dyeghikoo/design-power-distributor/README.md

# design-power-distributor
Diseño de un distribuidor de potencia con ADS
