dyeghikoo/design-power-distributor/MEMORIA STEP1.pdf

## Juan Diego Sierra Fernández & Daniel Sanz Muñoz

# PRÁCTICAS MEDIOS DE TRANSMISIÓN

# PRACTICA 1

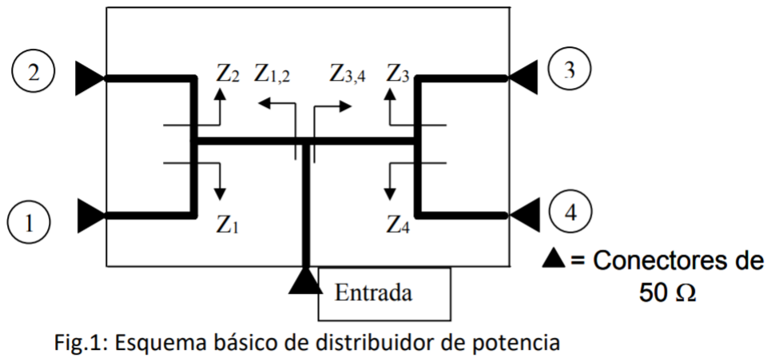
[picture p1: figure]
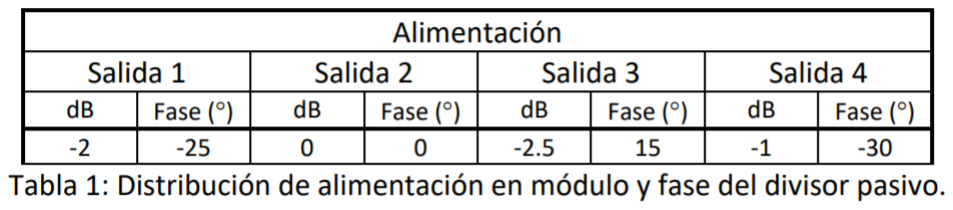
[picture p2: figure]

Practica 1 Medios de Transmisión

## DISEÑO 1: DISTRIBUIDOR DE POTENCIA

Nuestro objetivo es diseñar un circuito como el mostrado en la figura 1 cumpliendo los requisitos que aparecen en la tabla 1 además de cumplir las especificaciones que se muestran a continuación:

- La impedancia característica de las líneas que se implementen esté en el rango
25 < Z0i < 85 (Ω).
- Adaptadores en λ/4.
- Banda de trabajo: 3.2 – 3.8 GHz.
- Coeficiente de reflexión a la entrada del circuito: < - 30 dB
- Rizado en amplitud de transmisión: +/- 0.5 dB
- Rizado en fase de transmisión con respecto al puerto de salida tomado como referencia: +/-5 º con respecto al valor nominal indicado en la tabla de especificaciones.

Para ello comenzamos diseñando los adaptadores en las salidas, esto lo conseguimos usando la tabla anterior que nos da la relación de potencias entre las distintas ramas del circuito, en este caso todas referenciadas a Z2.

Para todas las ramas del circuito vamos a utilizar adaptadores en λ/4, con esto podemos

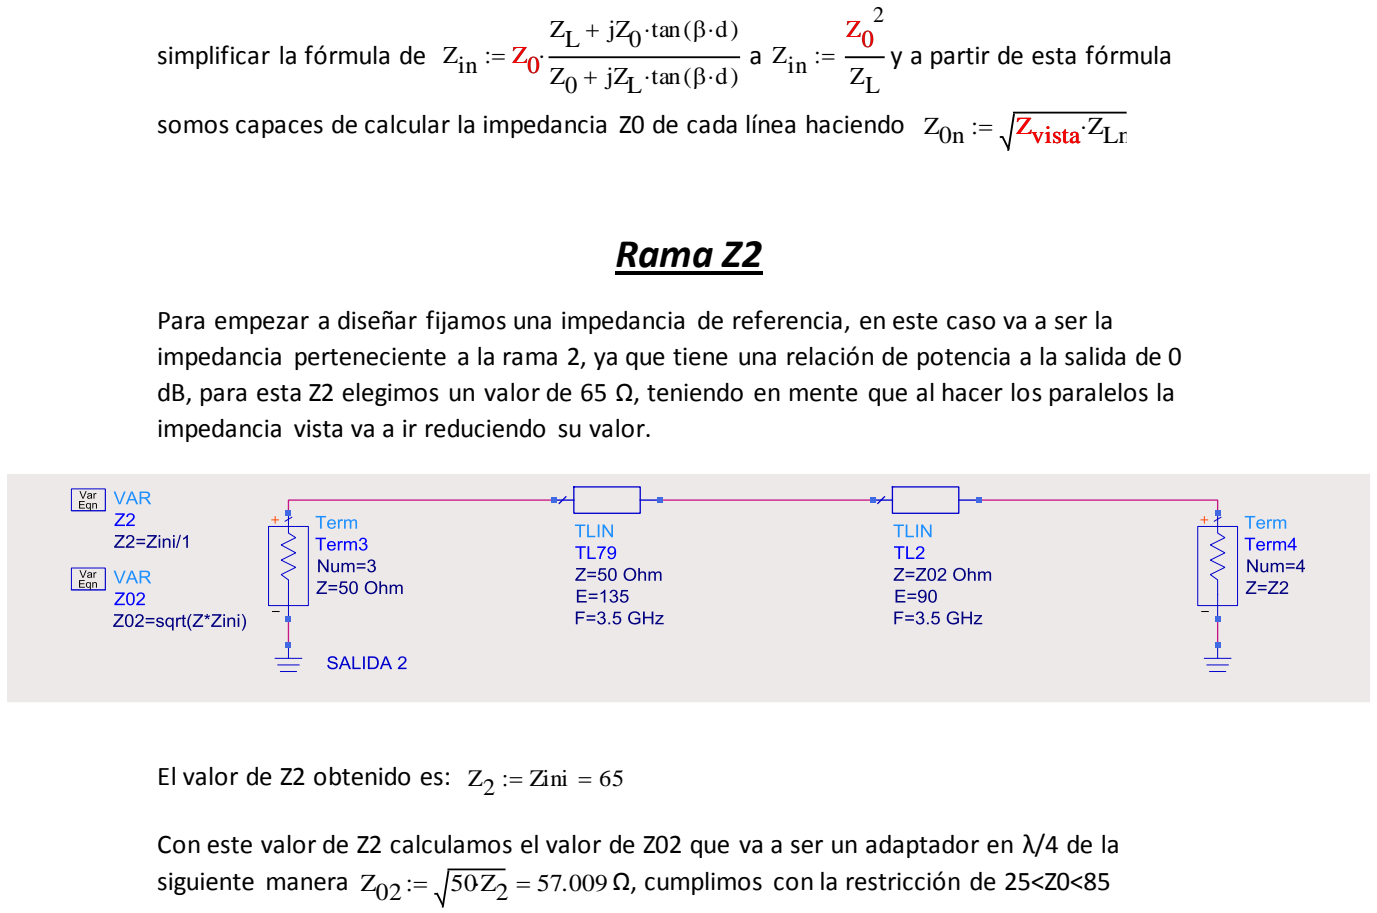
[picture p3: figure]
Rama Z2; El valor de Z2 obtenido es:; Zin; ·tan(β·d); jZL; Zvista ZLn := Z; · vista Z2; := Zini = 65 Z02

simplificar la fórmula de | a | y a partir de esta fórmula

somos capaces de calcular la impedancia Z0 de cada línea haciendo

Para empezar a diseñar fijamos una impedancia de referencia, en este caso va a ser la impedancia perteneciente a la rama 2, ya que tiene una relación de potencia a la salida de 0 dB, para esta Z2 elegimos un valor de 65 Ω, teniendo en mente que al hacer los paralelos la impedancia vista va a ir reduciendo su valor.

Con este valor de Z2 calculamos el valor de Z02 que va a ser un adaptador en λ/4 de la
siguiente manera | Ω, cumplimos con la restricción de 25<Z0<85

Con estos valores comprobamos la respuesta en frecuencia y el valor de Z02

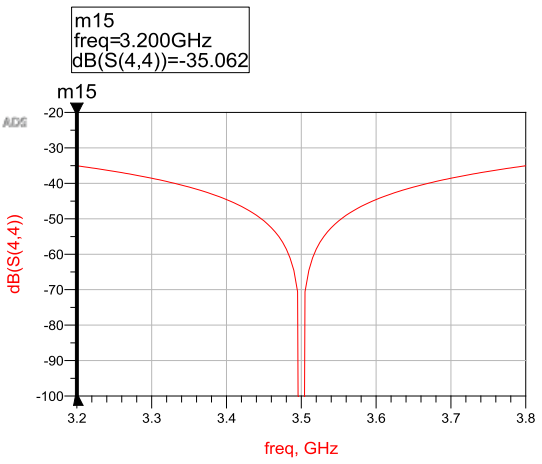
[picture p4: figure]
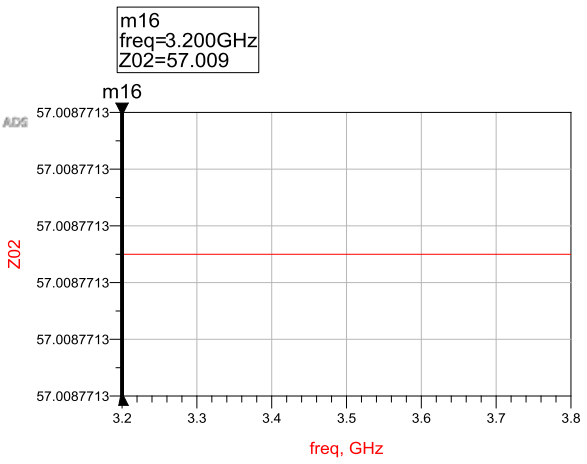
[picture p5: figure]

Observamos que a la frecuencia de diseño (3.5GHz) la adaptación es perfecta y en los extremos (3.2GHz y 3.8GHz) obtenemos una respuesta inferior a -30dB, cumpliendo con las restricciones del enunciado.

## Rama Z1

A partir de los datos de la tabla, la impedancia que hemos elegido y haciendo uso de la

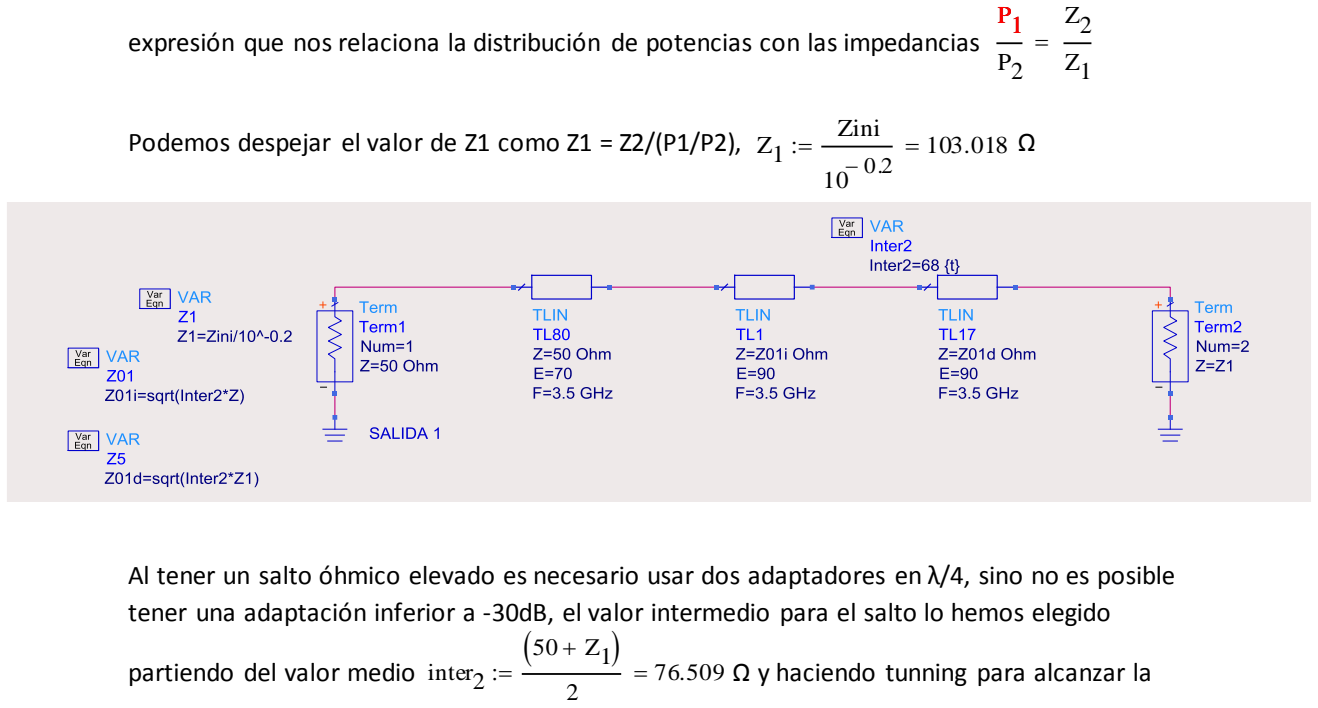
[picture p6: figure]
Zini; = 103.018 inter2

expresión que nos relaciona la distribución de potencias con las impedancias

Podemos despejar el valor de Z1 como Z1 = Z2/(P1/P2), | Ω

Al tener un salto óhmico elevado es necesario usar dos adaptadores en λ/4, sino no es posible tener una adaptación inferior a -30dB, el valor intermedio para el salto lo hemos elegido

partiendo del valor medio | Ω y haciendo tunning para alcanzar la

mejor respuesta posible, en este caso inter2=68.

Obtenemos la siguiente respuesta en frecuencia y valores de Z0:

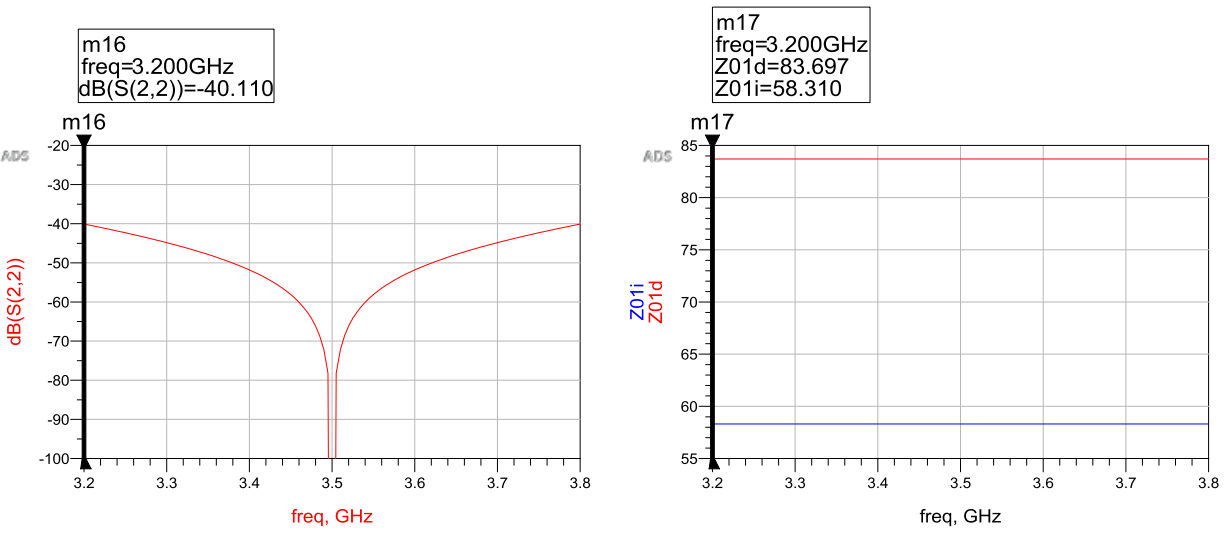
[picture p7: figure]

Observamos que a la frecuencia de diseño (3.5GHz) la adaptación es perfecta y en los extremos (3.2GHz y 3.8GHz) obtenemos una respuesta inferior a -30dB, en el caso de las impedancias ambas se encuentran dentro de los márgenes 25<Z0<85 Ω

## Rama Z3

A partir de los valores de la tabla y la siguiente relación P3/P2=Z2/Z3 somos capaces de

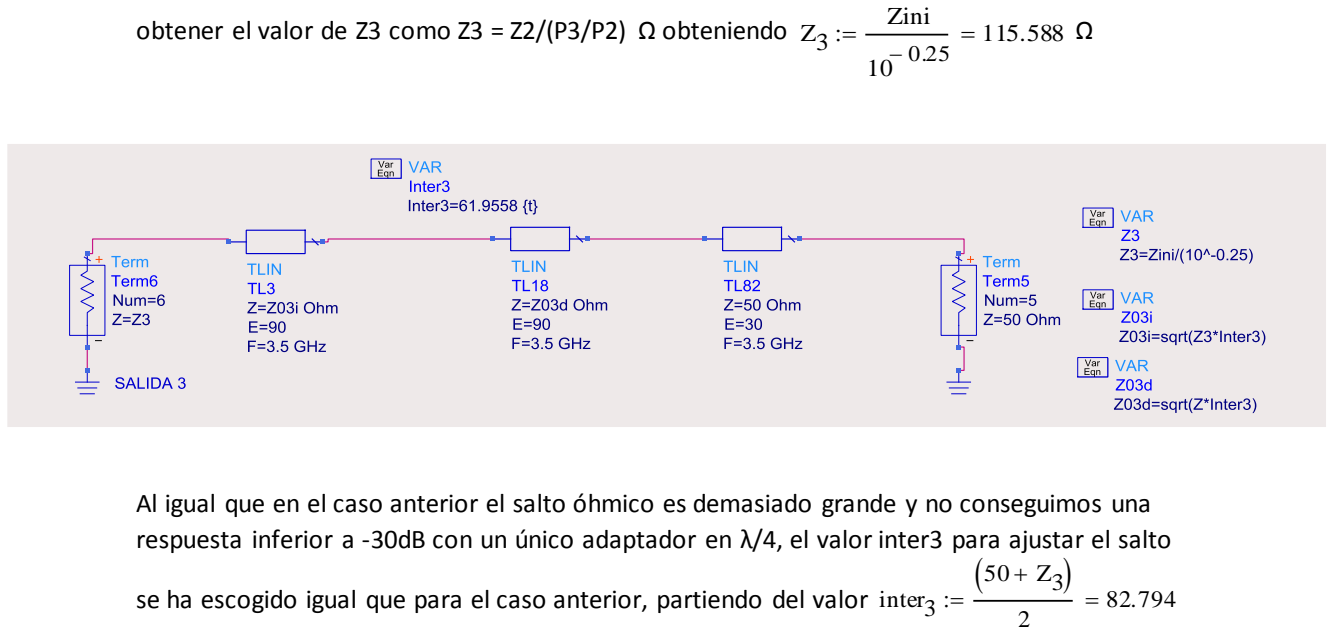
[picture p8: figure]
Zini; = 115.588 inter3

obtener el valor de Z3 como Z3 = Z2/(P3/P2) Ω obteniendo | Ω

Al igual que en el caso anterior el salto óhmico es demasiado grande y no conseguimos una respuesta inferior a -30dB con un único adaptador en λ/4, el valor inter3 para ajustar el salto

se ha escogido igual que para el caso anterior, partiendo del valor

Ω y ajustando el valor para obtener la mejor respuesta posible mediante tunning en este caso inter3 = 61.9558 Ω, para otros valores de inter3 obteníamos una respuesta inferior en dB pero dejábamos de cumplir la restricción para Z0 de 25<Z0<85 Ω.

Obtenemos la siguiente respuesta en frecuencia y valores de Z0:

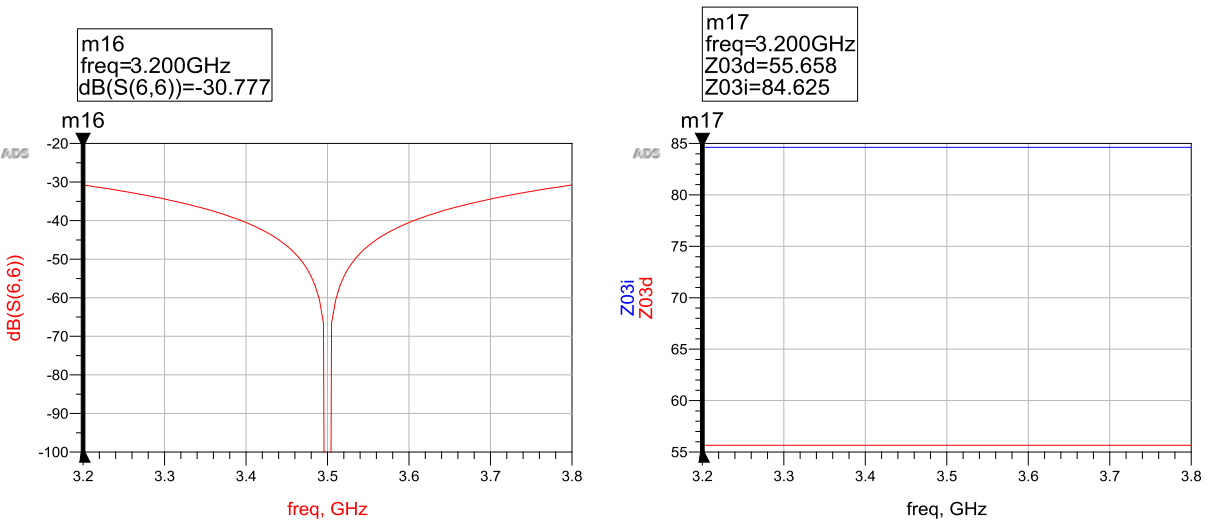
[picture p9: figure]

Observamos que a la frecuencia de diseño (3.5GHz) la adaptación es perfecta y en los extremos (3.2GHz y 3.8GHz) obtenemos una respuesta inferior a -30dB, en el caso de las impedancias ambas se encuentran dentro de los márgenes 25<Z0<85 Ω

## Rama Z4

A partir de los valores de la tabla y la siguiente relación P4/P2=Z2/Z4 somos capaces de

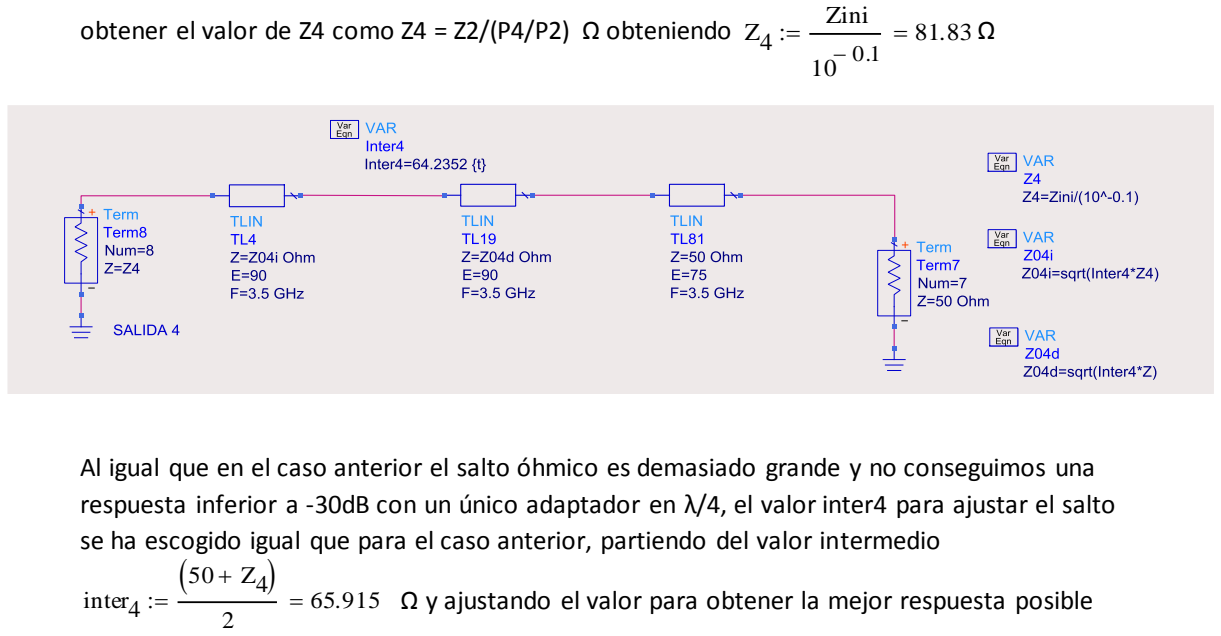
[picture p10: figure]
Zini; = 81.83 inter4

obtener el valor de Z4 como Z4 = Z2/(P4/P2) Ω obteniendo | Ω

Al igual que en el caso anterior el salto óhmico es demasiado grande y no conseguimos una respuesta inferior a -30dB con un único adaptador en λ/4, el valor inter4 para ajustar el salto se ha escogido igual que para el caso anterior, partiendo del valor intermedio

Ω y ajustando el valor para obtener la mejor respuesta posible

mediante tunning en este caso inter4 = 64.2352 Ω.

Obtenemos la siguiente respuesta en frecuencia y valores de Z0:

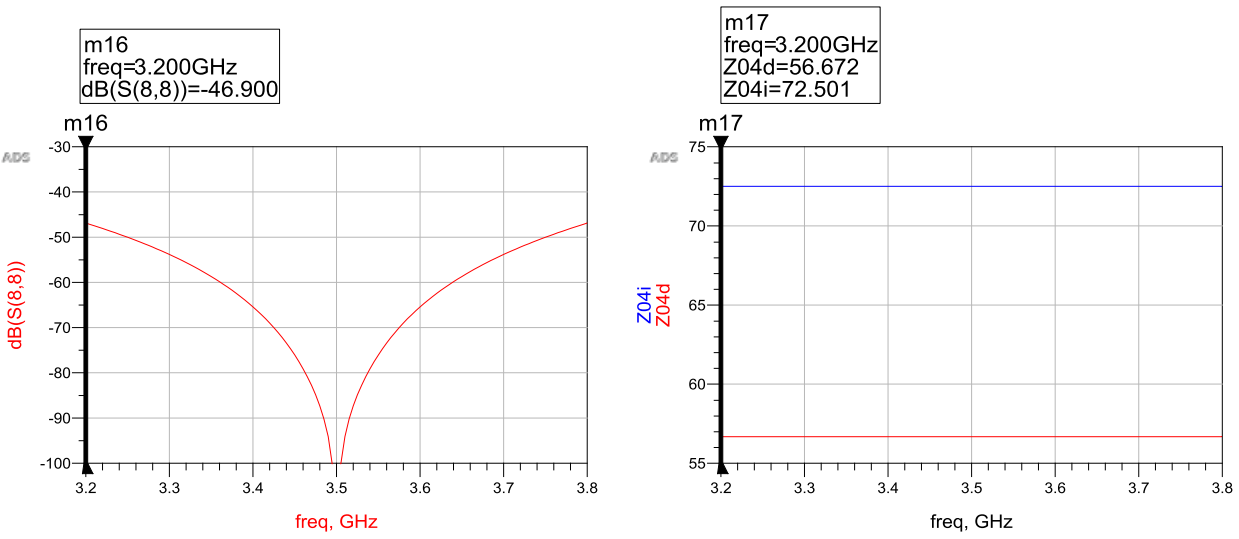
[picture p11: figure]

Observamos que a la frecuencia de diseño (3.5GHz) la adaptación es perfecta y en los extremos (3.2GHz y 3.8GHz) obtenemos una respuesta inferior a -30dB, en el caso de las impedancias ambas se encuentran dentro de los márgenes 25<Z0<85 Ω

Diseñando las ramas por separado hemos conseguido una adaptación inferior a -30dB en todas ellas, y unas impedancias Z0 dentro de los limites propuestos, ahora procedemos a unir las ramas y comprobar que seguimos manteniendo la adaptación.

## Rama Z1,2

En este caso la impedancia vista corresponde al paralelo Z12 = Z1||Z2,

Ω. Conectamos directamente las ramas a un generador de este

valor para ver si la respuesta sigue adaptada.

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
:= | = 39.854

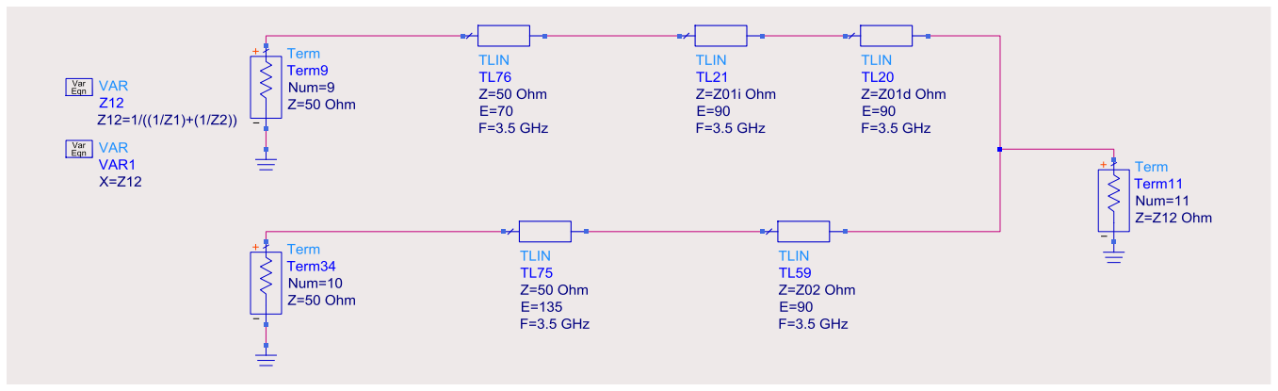
[picture p12: figure]
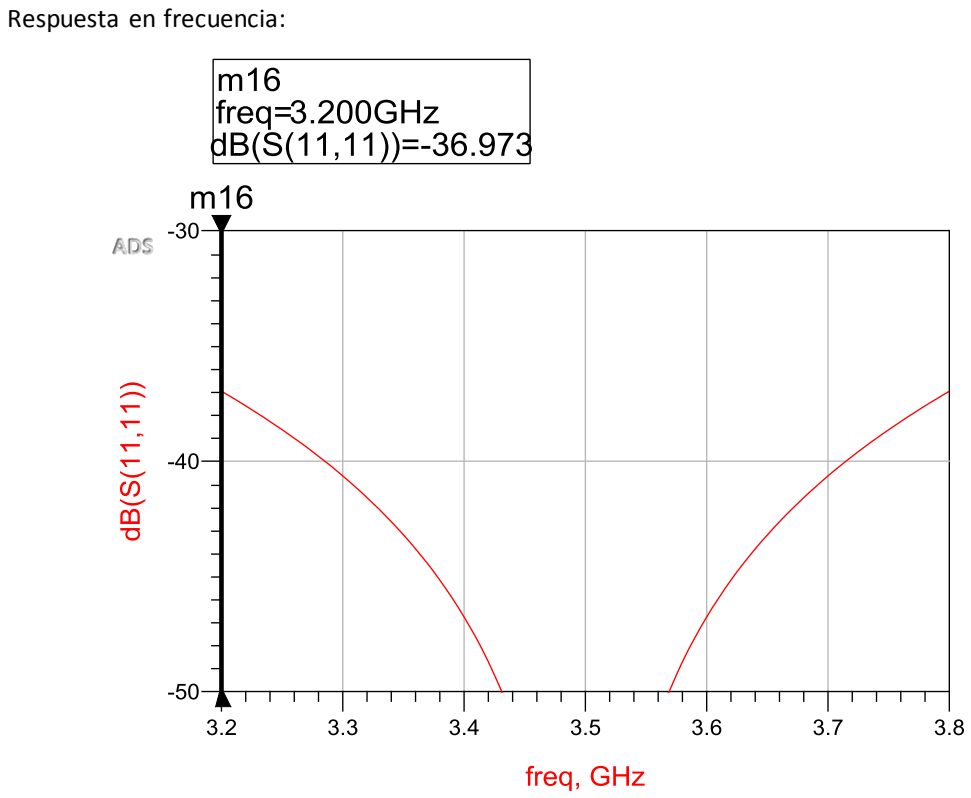
[picture p13: figure]
Respuesta en frecuencia:

La respuesta sigue adaptada y procedemos a colocar el adaptador λ/4:

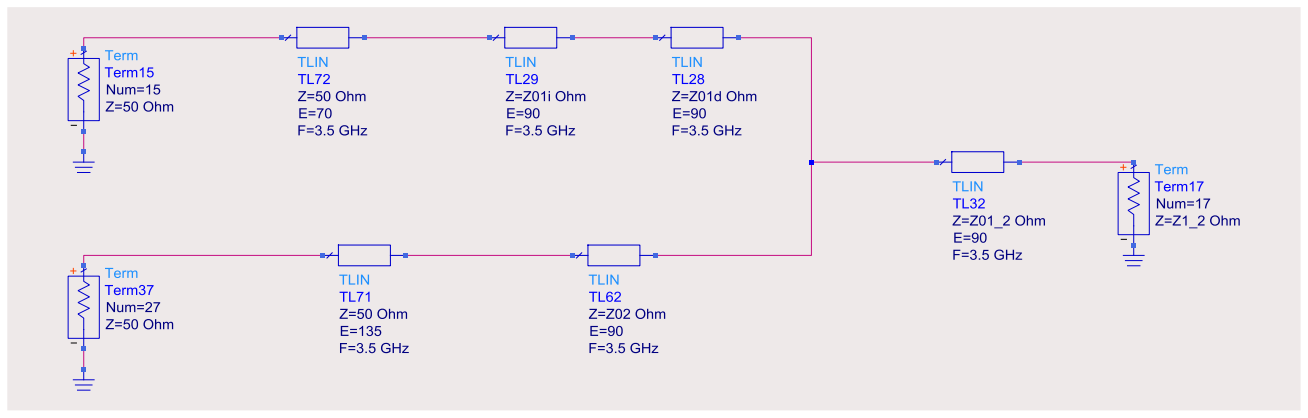
[picture p14: figure]

El valor Z = Z1_2 es un valor escogido por nosotros teniendo en mente que al hacer los paralelos en la última etapa la impedancia Z0 va a disminuir y es conveniente tener una impedancia por encima de 20 Ω, en este caso hemos escogido Z1_2 =60 Ω.

El valor de Z01_2 se calcula | Ω.

Respuesta en frecuencia e impedancia Z01_2:

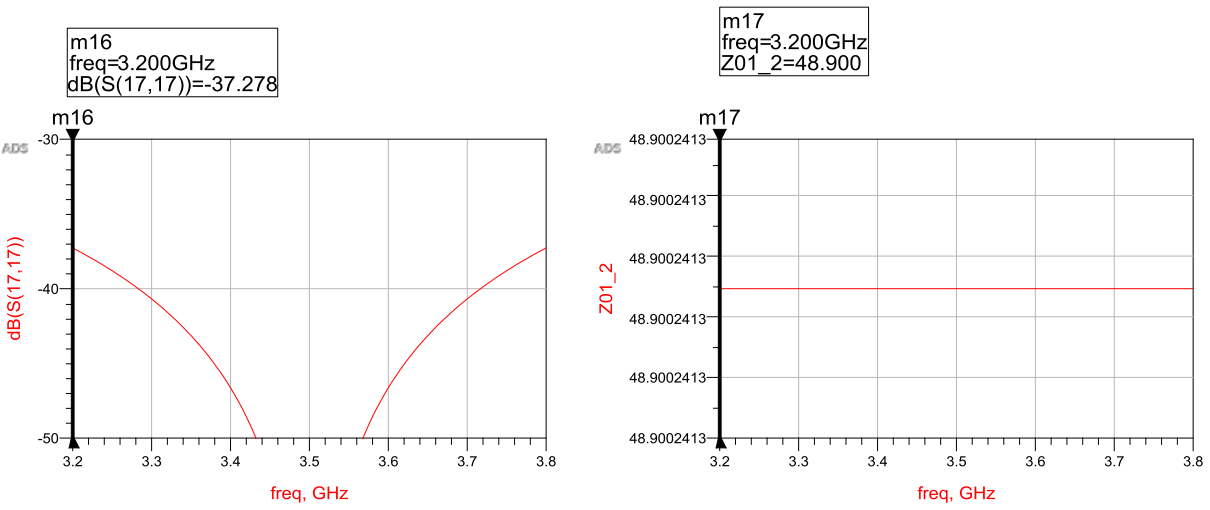
[picture p15: figure]
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

Z01_2 | Z12 Z1_2 := | · | = 48.9

## Rama Z3,4

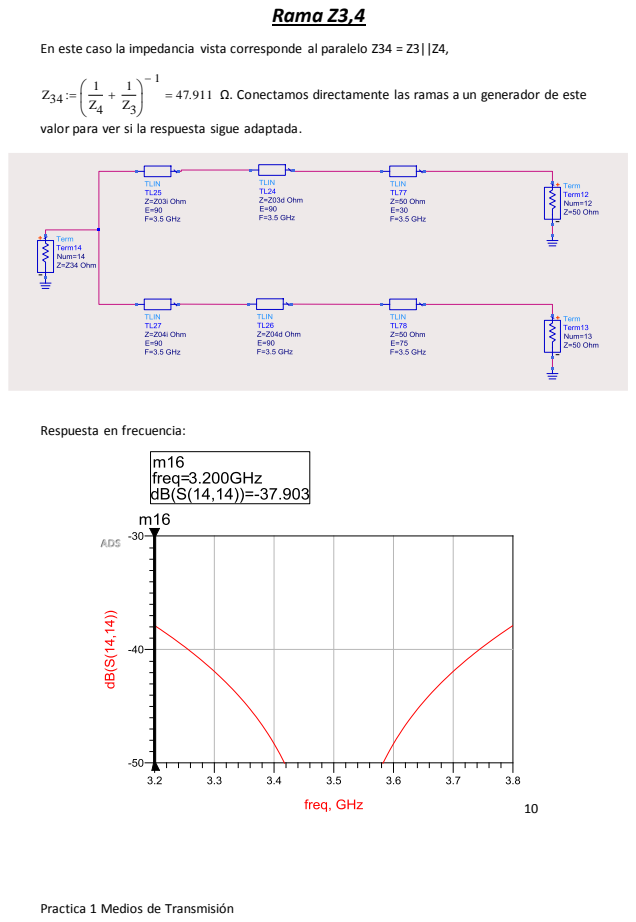
[picture p16: page 9]
valor para ver si la respuesta sigue adaptada.

En este caso la impedancia vista corresponde al paralelo Z34 = Z3||Z4,

Ω. Conectamos directamente las ramas a un generador de este

Respuesta en frecuencia:

La respuesta sigue adaptada y procedemos a colocar el adaptador λ/4:

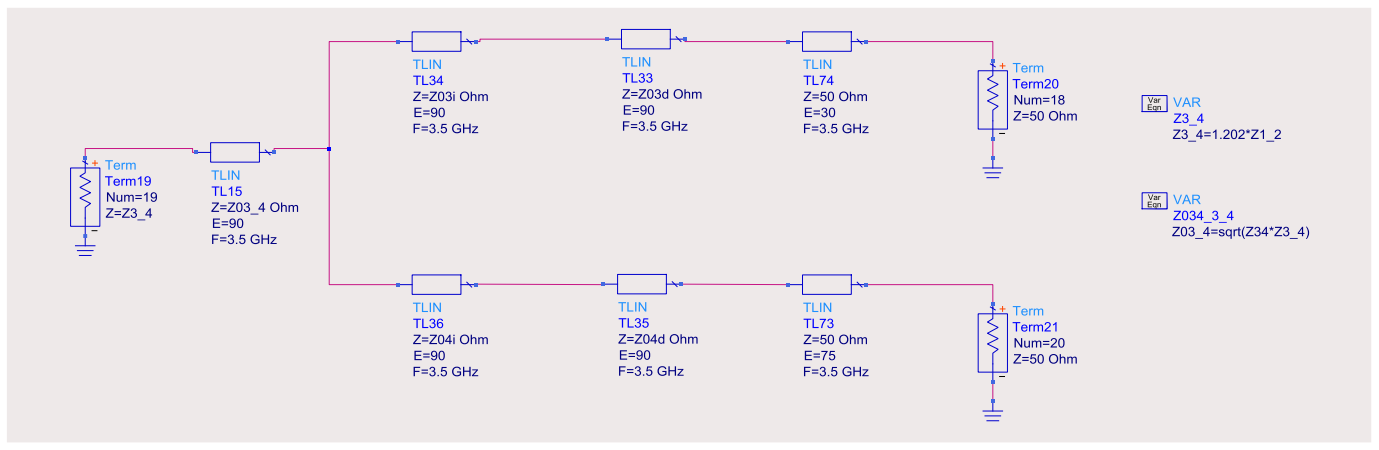
[picture p17: figure]

El valor Z3_4 se calcula a partir de la relación de potencia de (P3+P4)/(P1+P2)=Z1_2/Z3_4,

Ω.

Respuesta en frecuencia e impedancia Z03_4:

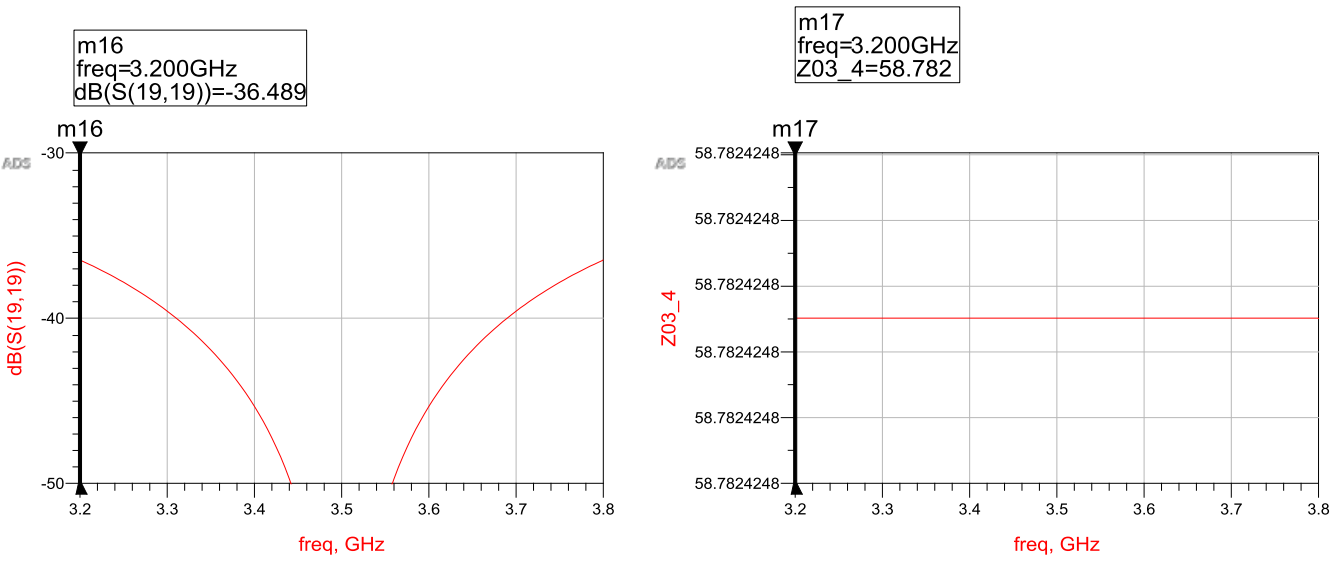
[picture p18: figure]
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

Z3_4

Z1_2 10- 0.2

·( | | | + 1)
10- 0.25 | 10- 0.1 ( | + | )
:= | = 72.131

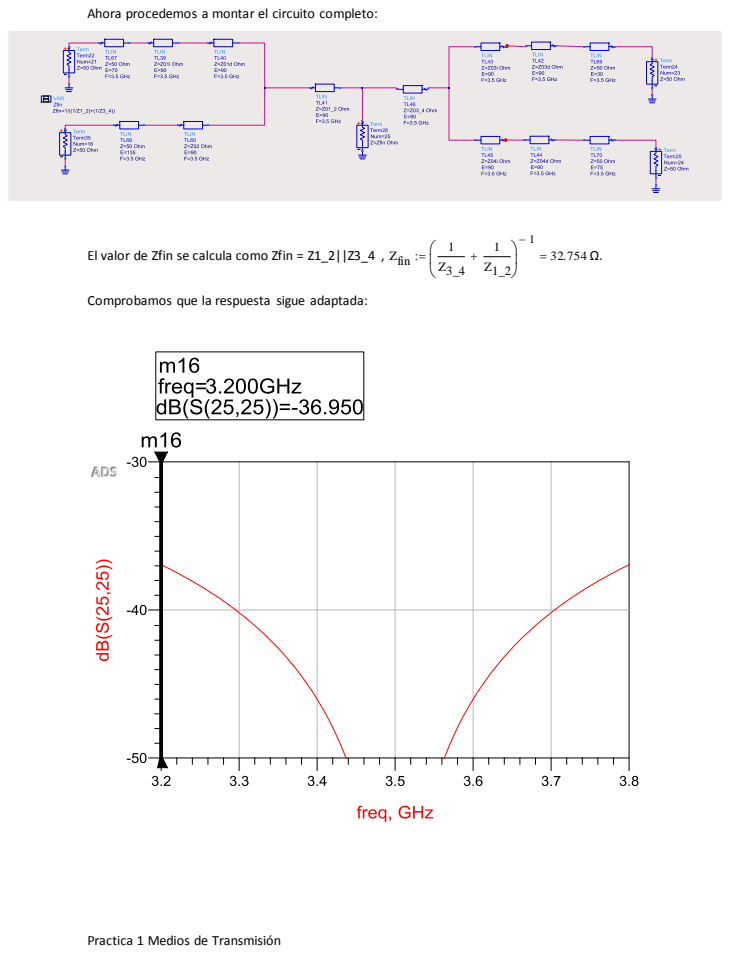
[picture p19: page 11]
El valor de Zfin se calcula como Zfin = Z1_2||Z3_4 ,; Zfin

Ahora procedemos a montar el circuito completo:

Comprobamos que la respuesta sigue adaptada:

La respuesta sigue adaptada y procedemos a colocar el adaptador λ/4:

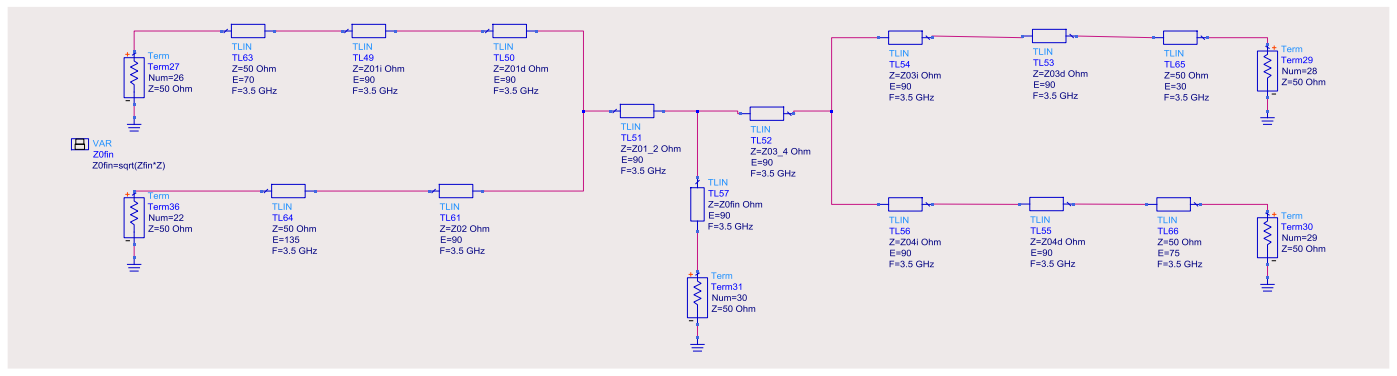
[picture p20: figure]

Z0fin se calcula como | Ω, un valor alto para no tener problemas, en
principio, para la práctica 2.

Comprobamos la respuesta en frecuencia y valor de Z0fin:

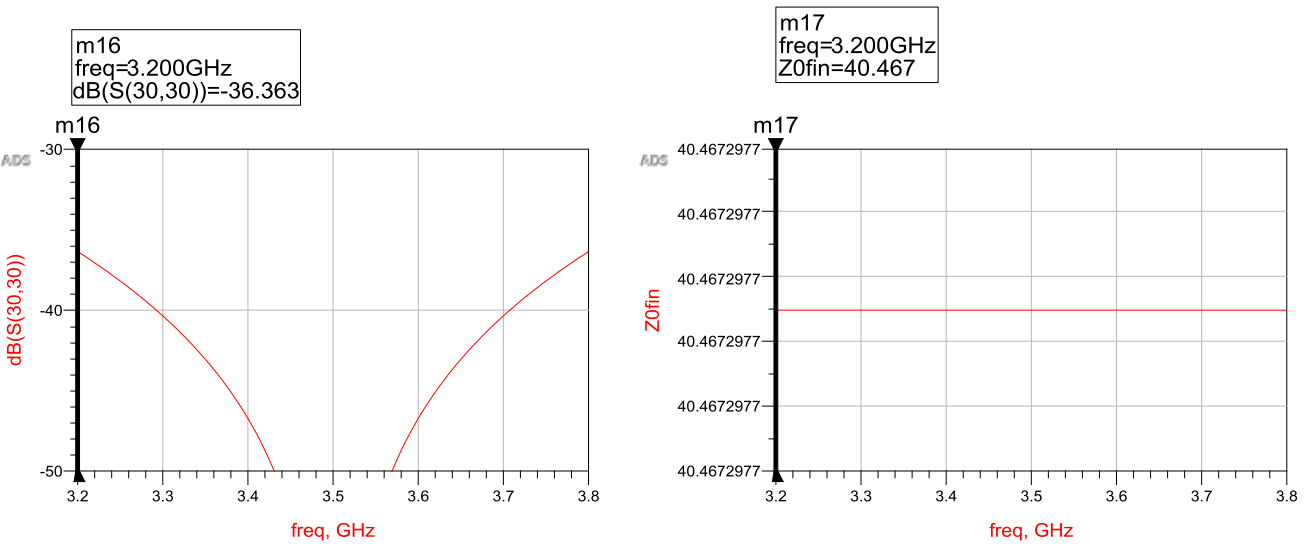
[picture p21: figure]
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

Z0fin | Zfin := | ·50 = 40.469

Una vez terminado el diseño procedemos a ajustar las fases de acuerdo con la tabla del enunciado.

Para adaptar la fase entre las distintas señales utilizamos una línea de transmisión de impedancia Z = 50 Ω con la que variaremos la longitud para obtener el desfase adecuado. Este proceso se podría haber hecho siguiendo dos caminos. Uno sería utilizando como referencia la línea 3, que es la que mayor fase tiene, y a partir de ella ir calculando la longitud de las demás. Y el otro, que ha sido nuestro caso, sería utilizar la misma línea 2 que hemos usado como referencia para las relaciones de potencia, pero en esta hemos tenido que añadir una línea de transmisión con E=135 para que no saliesen longitudes muy elevadas en el resto de salidas. Con esto hemos conseguido los siguientes valores para el resto de las líneas:
Línea 1 → E = 70° | Línea 3 → E = 30°
Línea 2 → E = 135° | Línea 4 → E = 75°

## Comprobaciones

- Relaciones de potencia:

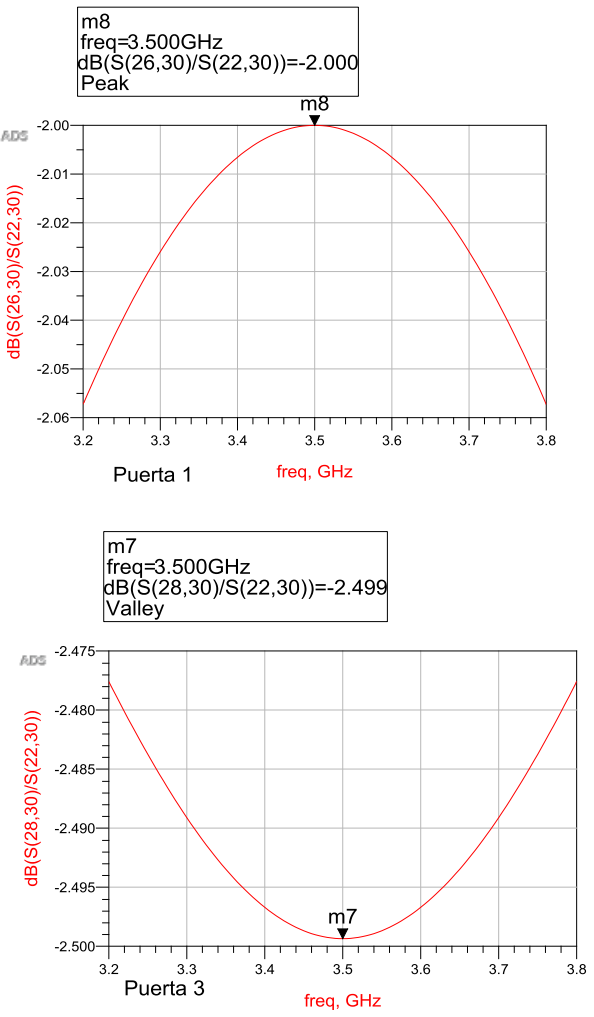
[picture p22: figure]
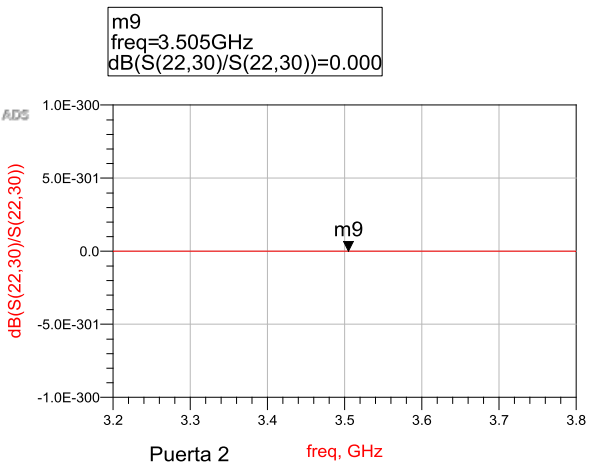
[picture p23: figure]
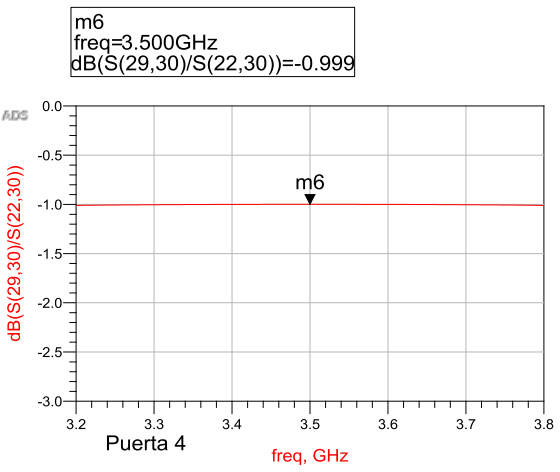
[picture p24: figure]
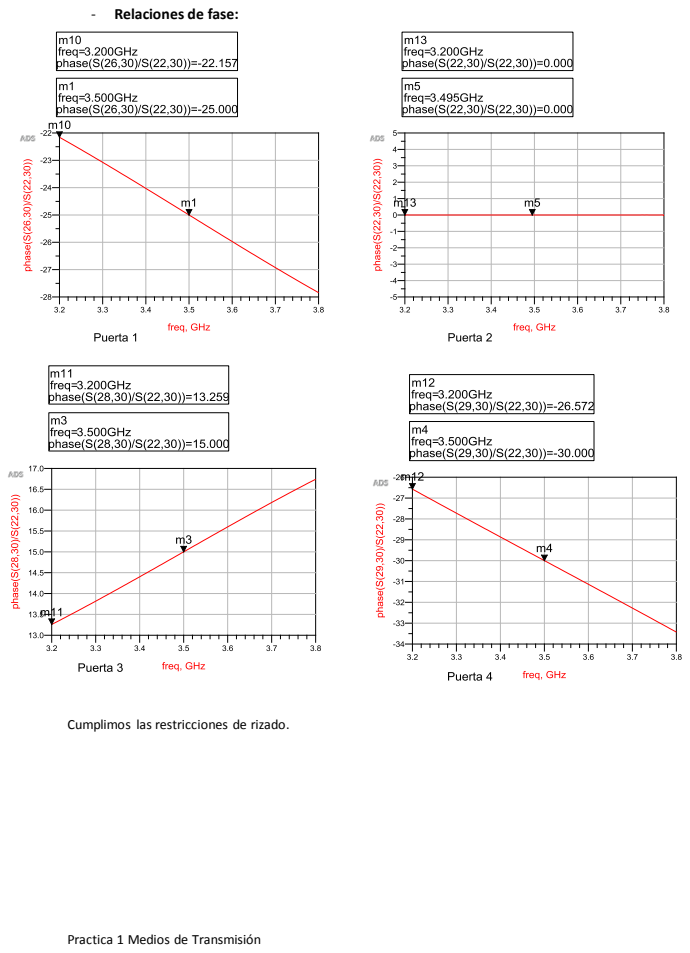
[picture p25: page 14]

- Relaciones de fase:

Cumplimos las restricciones de rizado.

## Resultados

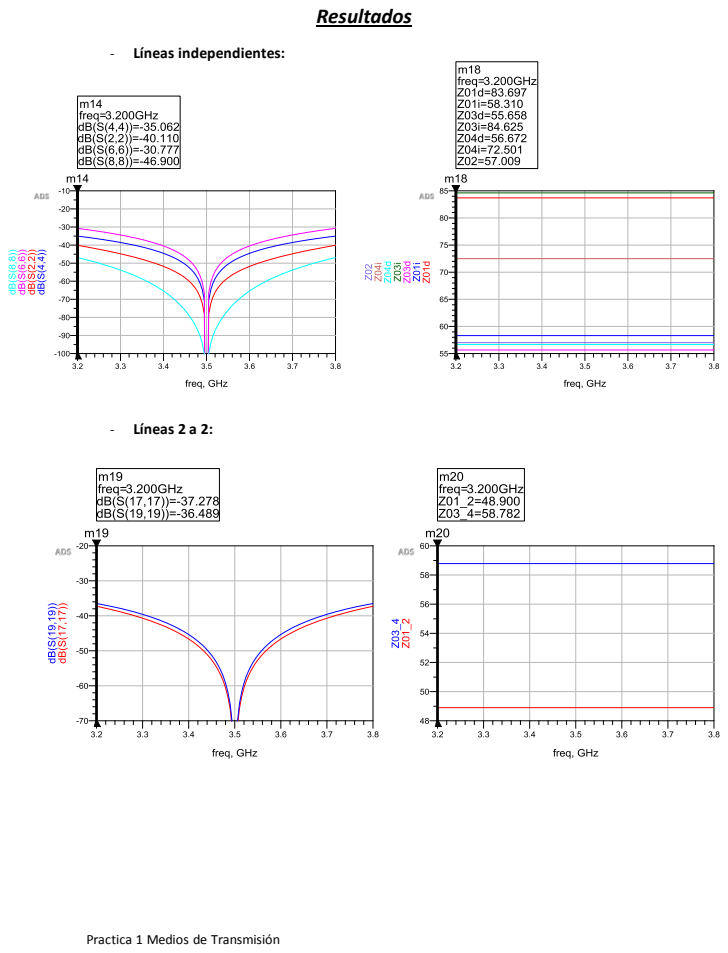
[picture p26: page 15]
- Líneas independientes:; - Líneas 2 a 2:

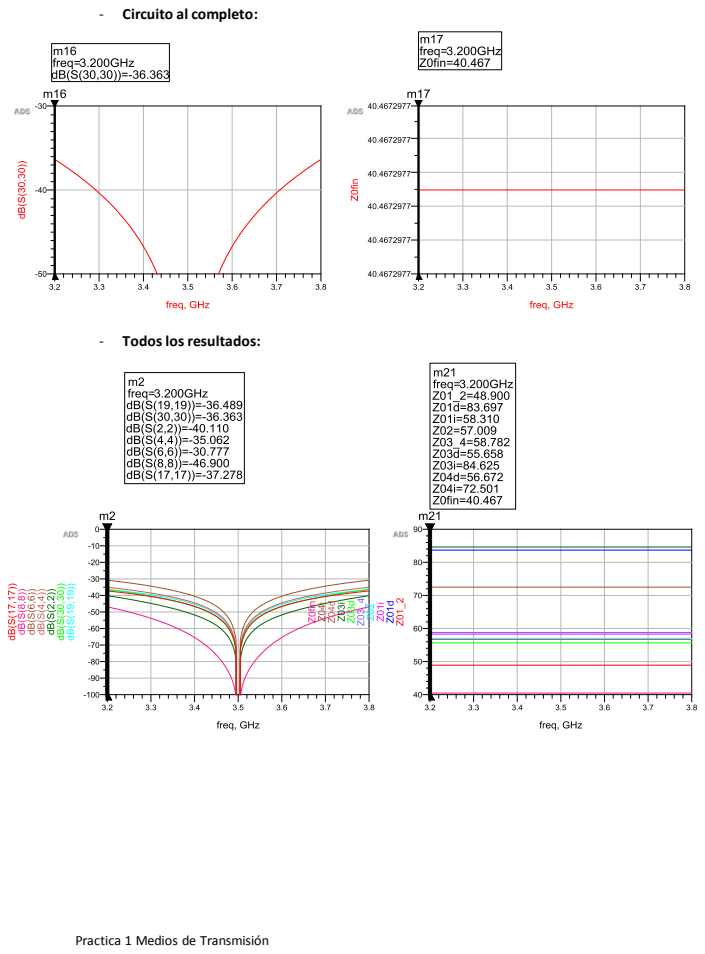
[picture p27: page 16]

- Circuito al completo:

- Todos los resultados:

- Tabla de valores:
Zini := = 103.018 Ω Z1 10- 0.2 | Valores iniciales de inter2 Ω Z01d := 50 inter2 inter2 · Z1 = 88.78 Z01i Ω := · = 61.85 Z2
Ω := Zini = 65 | Ω Z02 := 50 Z2 · = 57.009 Z3
:= Zini = 115.588 Ω 10- 0.25 | Valores iniciales de inter3 Z03i := inter3 50 inter2 · Z3 = 97.826 Z03d Ω := · = 61.85 Z4 Ω
:= Zini = 81.83 Ω 10- 0.1 | Valores iniciales de inter4 Z04i := inter4 50 inter4 · Z4 = 73.443 Z04d Ω Ω
Ω | Z01_2 := Z12 Z1_2 := · · = 57.409 Z1_2 := 60 = 48.9 Z3_4 Ω
·( + 1) Z1_2 10- 0.2 := = 72.131 Ω 10- 0.25 + 10- 0.1 ( ) | Z03_4 Z34 Z3_4 := · = 58.787 Zfin Ω
- 1 æ ö 1 1 Ω := ç + ÷ = 32.754 è Z3_4 Z1_2 ø | Ω Z0fin Zfin := ·50 = 40.469

## DISEÑO 2: ACOPLADOR HÍBRIDO BRANCHLINE

Para este caso las especificaciones son las mismas que en el diseño anterior excepto que la impedancia característica Z0V1 puede llegar a 110 Ω.

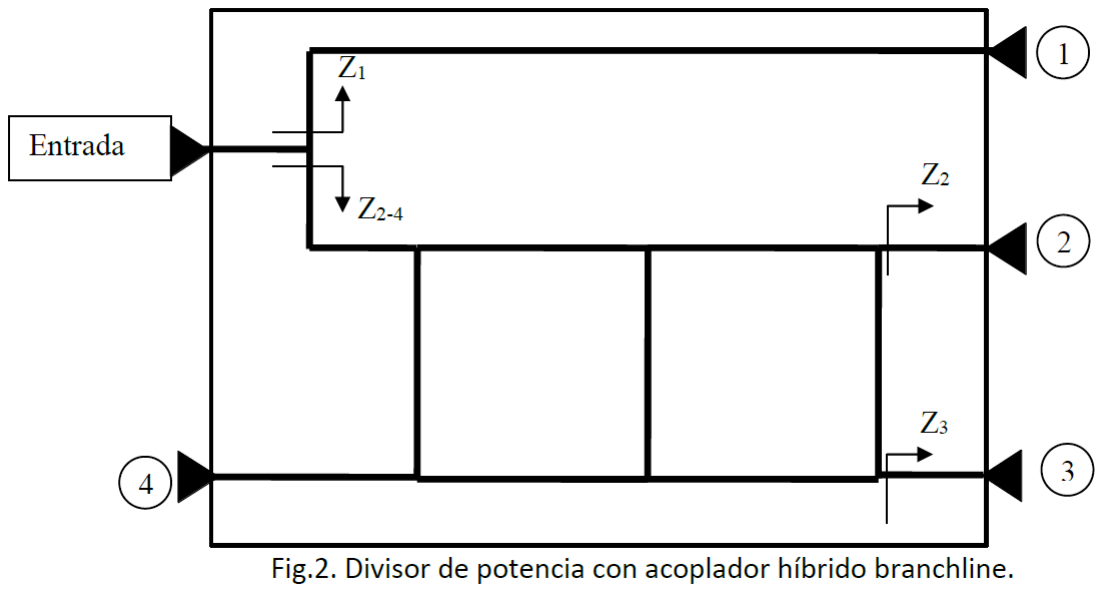
[picture p28: figure]
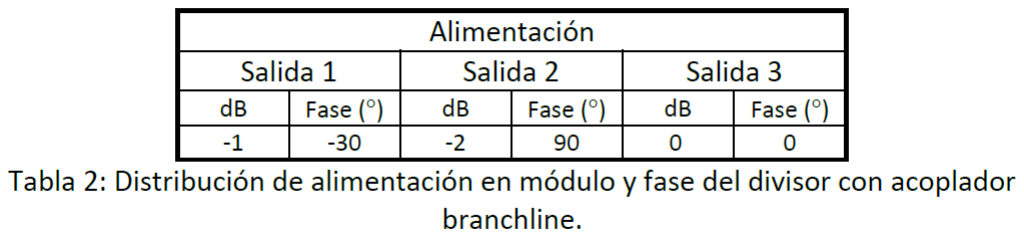
[picture p29: figure]

## BRANCHLINE

Para la realización de este diseño partimos del modelo del acoplador híbrido Branchline.

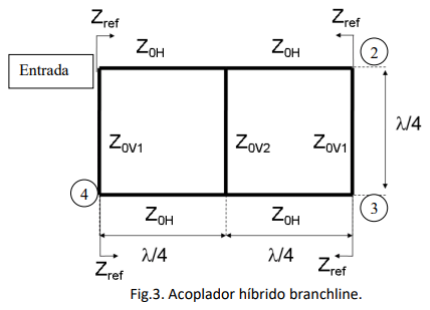
[picture p30: figure]

Comenzamos el diseño calculando la constante K que nos indica la distribución de potencia

entre las puertas | | , a partir de este resultado elegimos una Zref que
maximiza el valor de Z0v1, haciendo esto llegamos a un valor de | Ω y
| | Ω, por debajo del máximo de 110 Ω, con esto elegimos Z0H

de forma que nos quede un valor de Z0v2 dentro de los límites y la mejor respuesta posible del

circuito, | Ω y | Ω

Zref es el valor que se debería ver desde cada salida al resto del circuito como se muestra en la imagen.

K

100

10- 0.2

:= | = 1.259 | Zref := 53 Z0V1 | Zref
1 | 1 | K

2
+ | +
| K
:= | · | = 109.785 Z0H := 36 | Z0V2 | Z0H

2

Zref

2
Z0V1

2
+

2 Z0V1 · Zref

2
·

æ
è

ö
ø
:= | · | = 31.228

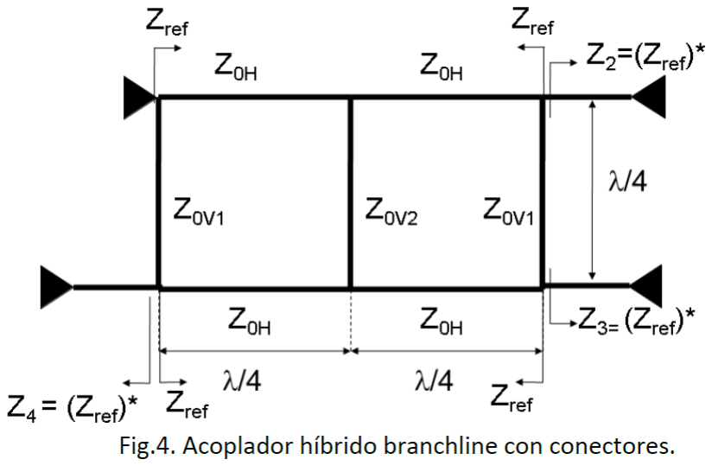
[picture p31: figure]
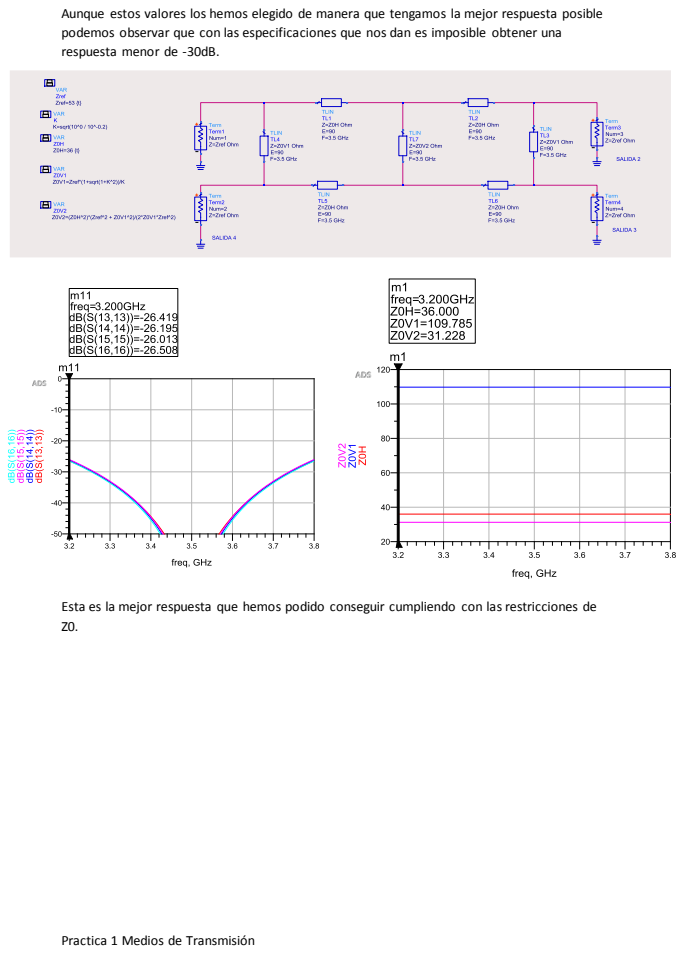
[picture p32: page 20]

Aunque estos valores los hemos elegido de manera que tengamos la mejor respuesta posible
podemos observar que con las especificaciones que nos dan es imposible obtener una
respuesta menor de -30dB.

Esta es la mejor respuesta que hemos podido conseguir cumpliendo con las restricciones de

### Circuito adaptado

Procedemos a colocar los adaptadores en λ/4, en este caso todos los valores de Z0 son iguales, ya que las impedancias vistas en todos los extremos del circuito es la misma, nos queda un

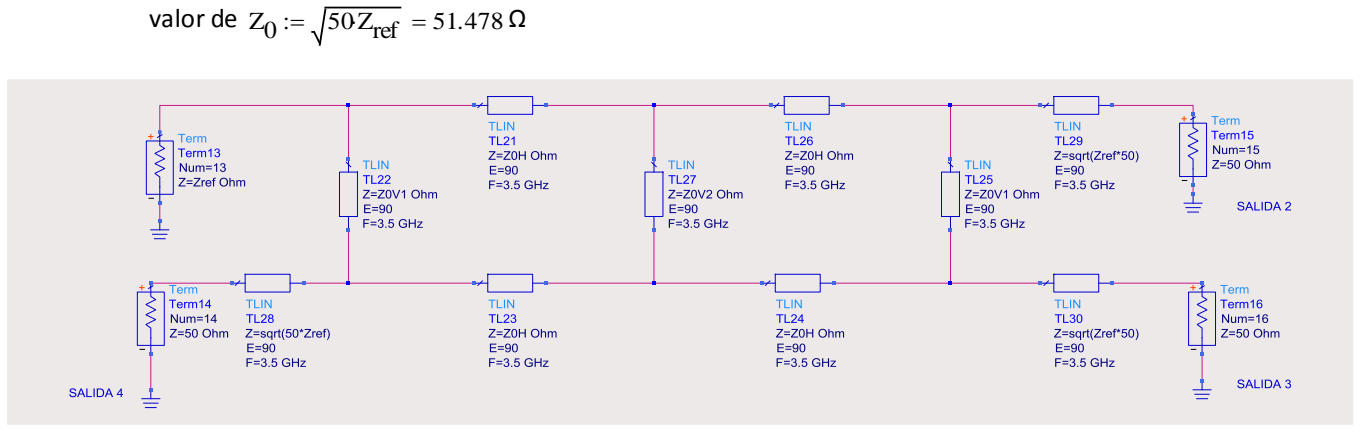
[picture p33: figure]
valor de; 50 Zref :=

Respuesta en frecuencia y valor de Z0:

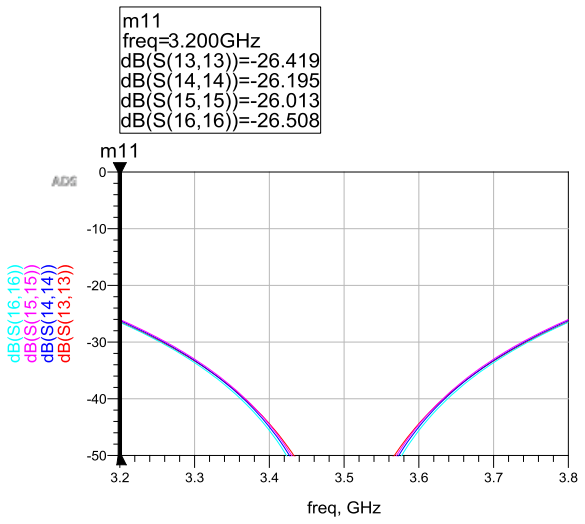
[picture p34: figure]
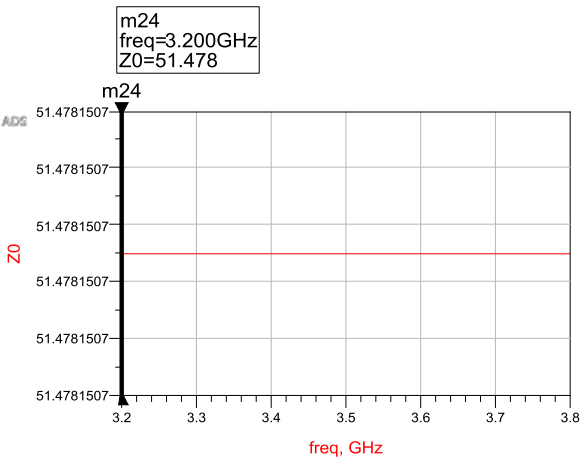
[picture p35: figure]

Vemos que la adaptación sigue sin llegar a -30dB fuera de la frecuencia de diseño y que el valor de Z0 está dentro de los límites 25<Z0<85Ω.

En este punto del diseño calculamos los valores de la rama que conecta el adaptador Branchline con la rama 1.

El valor de Z24 es un valor elegido por nosotros y ajustado haciendo tunning para obtener la
mejor respuesta en este caso | Ω

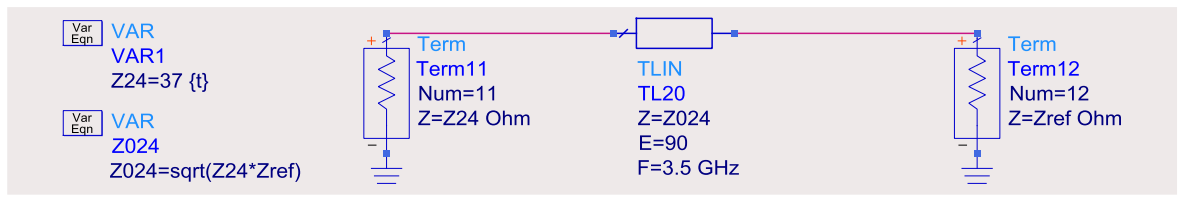
[picture p36: figure]

Respuesta en frecuencia y valor Z0:

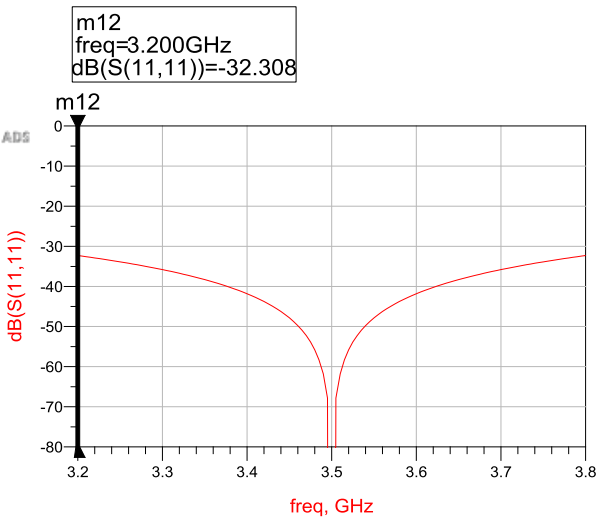
[picture p37: figure]
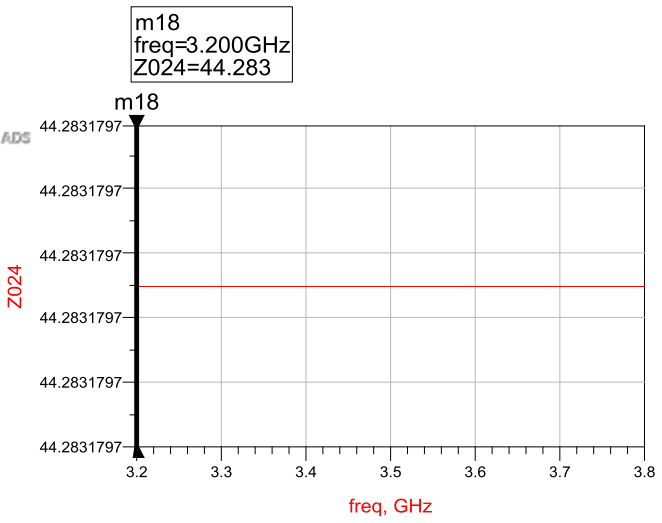
[picture p38: figure]

En este punto observamos que es la primera vez que conseguimos una adaptación por debajo de -30dB y el valor de Z024 sigue por debajo.

Z24 := 37

## Rama Z1

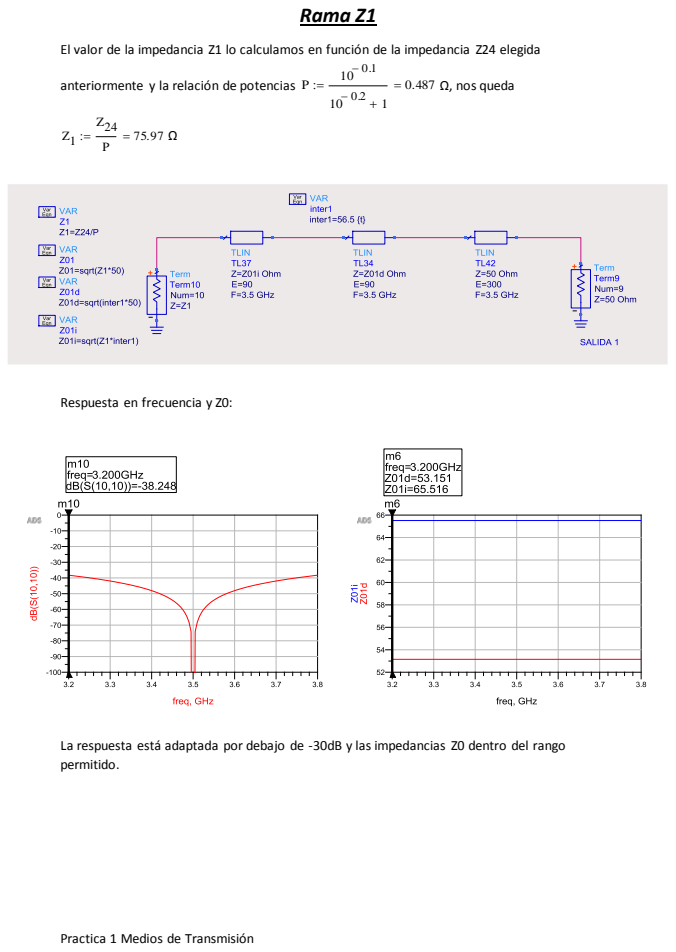
[picture p39: page 23]
anteriormente y la relación de potencias; Ω, nos queda

El valor de la impedancia Z1 lo calculamos en función de la impedancia Z24 elegida

Respuesta en frecuencia y Z0:

La respuesta está adaptada por debajo de -30dB y las impedancias Z0 dentro del rango
permitido.

## CIRCUITO ENTRADA A PARALELO

Simulamos de forma independiente el segmento del circuito que conecta la entrada con el valor visto de la resistencia de las dos líneas en paralelo con valor

Ω, el valor inter3 se ha calculado partiendo del valor

medio entre las impedancias Zp y 50Ω de la forma | Ω y ajustando

con tunning hasta conseguir la mejor respuesta del circuito.

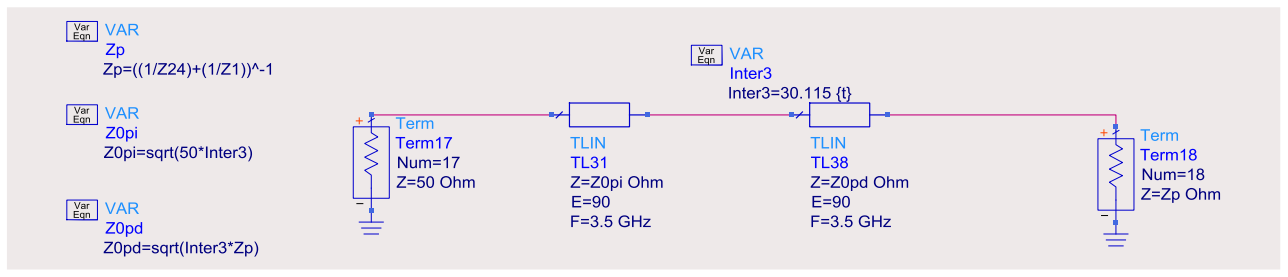
[picture p40: figure]

Respuesta en frecuencia y valor de Z0:

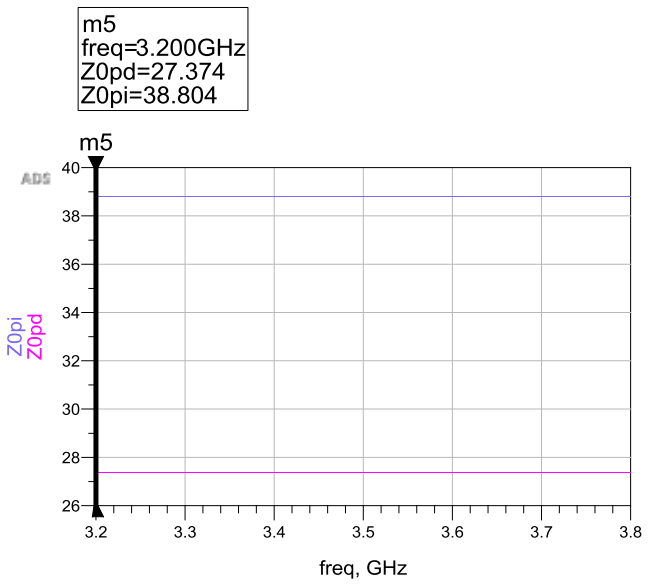
[picture p41: figure]
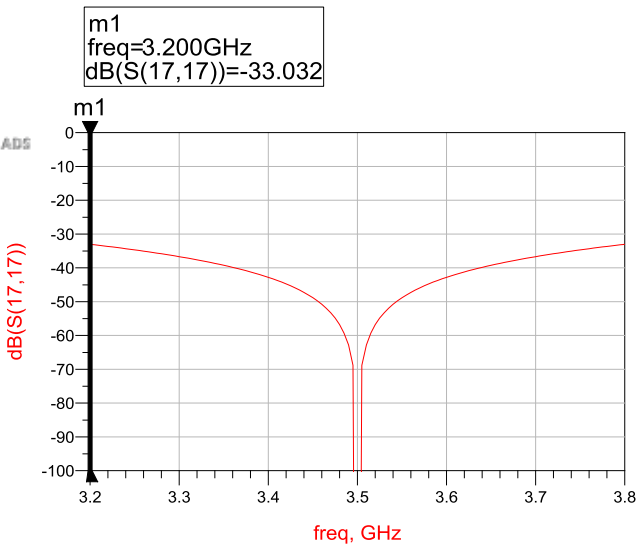
[picture p42: figure]

La respuesta del circuito está adaptada por debajo de -30dB y las impedancias Z0 están dentro de los límites.

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
:= | = 24.882 | inter3
50 | Zp ( + | )

2

:= | = 37.441

## CIRCUITO COMPLETO

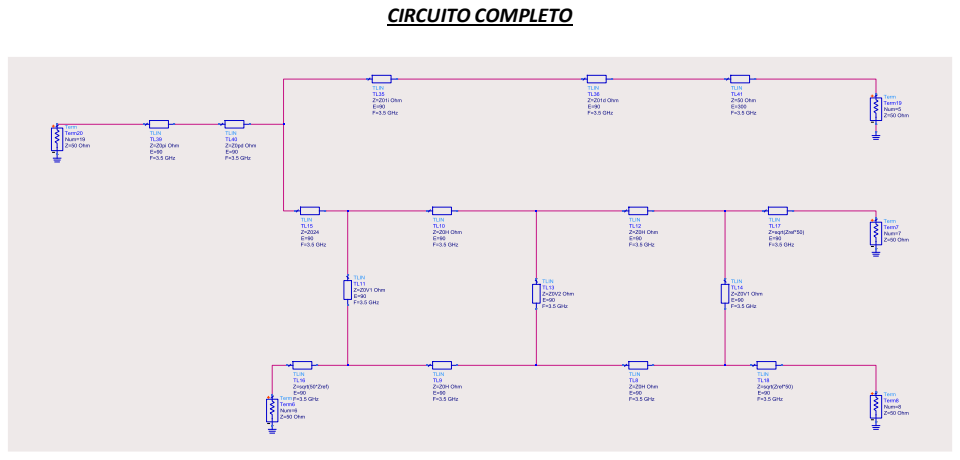
[picture p43: page 25]

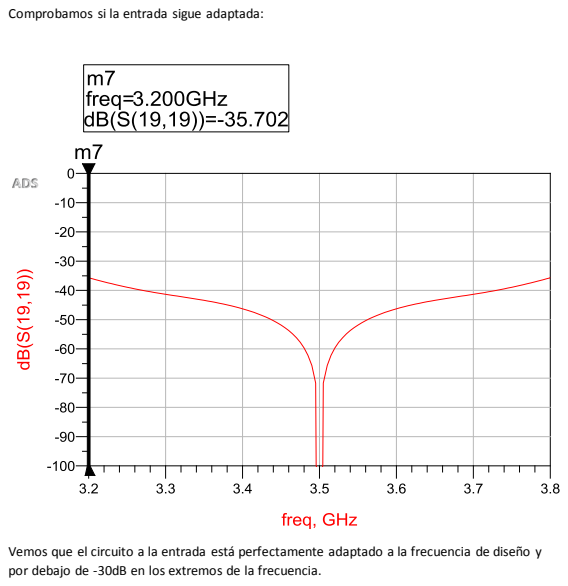
[picture p44: page 26]

Comprobamos si la entrada sigue adaptada:

Vemos que el circuito a la entrada está perfectamente adaptado a la frecuencia de diseño y
por debajo de -30dB en los extremos de la frecuencia.

## Comprobaciones

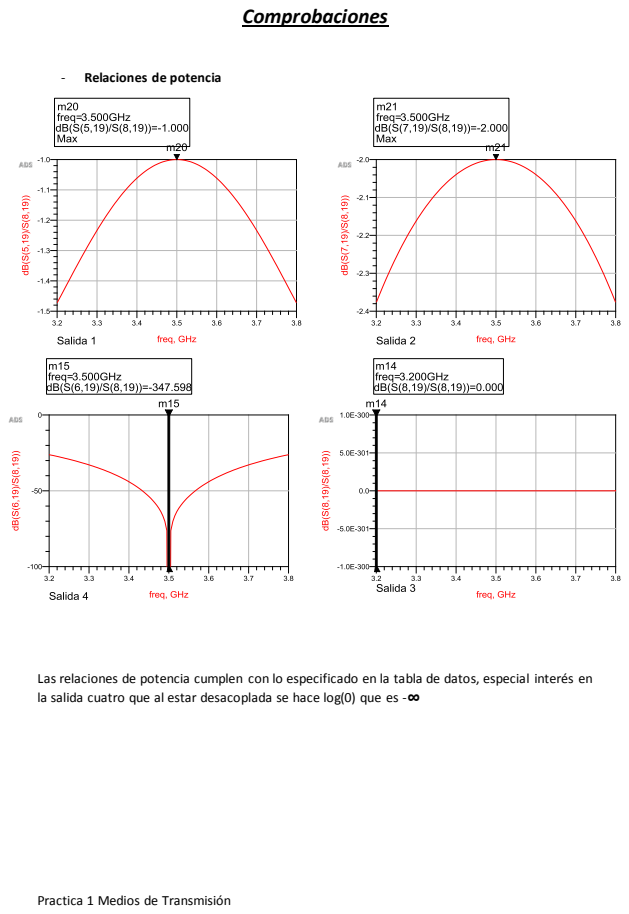
[picture p45: page 27]

- Relaciones de potencia

Las relaciones de potencia cumplen con lo especificado en la tabla de datos, especial interés en
la salida cuatro que al estar desacoplada se hace log(0) que es -∞

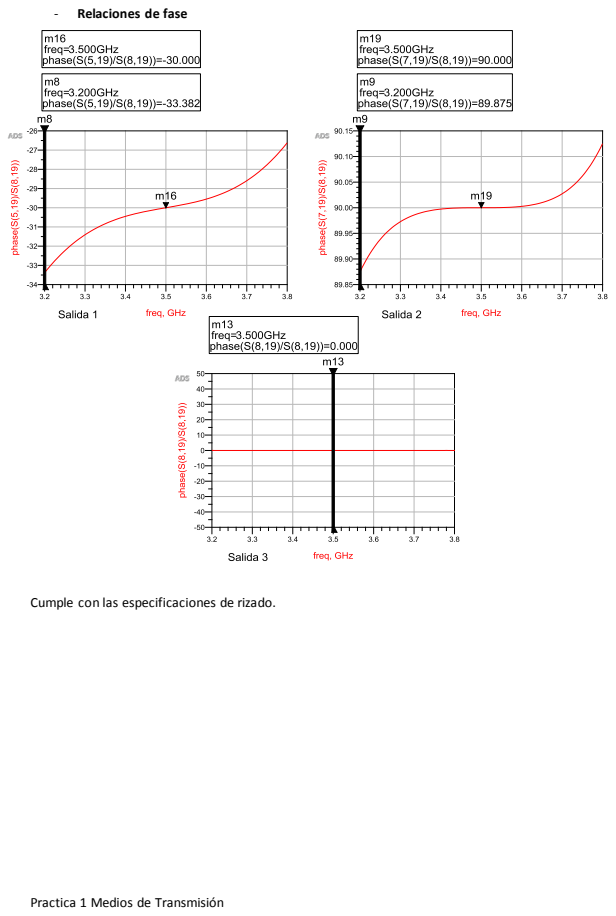
[picture p46: page 28]

- Relaciones de fase

Cumple con las especificaciones de rizado.

- Tabla de valores:
Zref := 53 Zref | 100 K := = 1.259 Z0V1 10- 0.2
2 1 + 1 + K := Z0H · = 109.785 K | Z0H := 36 Z0V2
2 2 Zref + Z0V1 2 := · = 31.228 æ ö 2 è 2 Z0V1 · · Zref ø | 10- 0.1 P Z0 := = 0.487 Z24 := 37 10- 0.2 + 1
| 50 Zref := · = 51.478 Z1
Z24 := = 75.97 P | - 1 æ ö 1 1 Zp := ç + ÷ = 24.882 inter3 è Z1 Z24 ø
50 Zp ( + ) := Zref Z1 = 37.441 2 | Z024 Zref Z24 := ( · ) = 44.283 Z01

:= · = 63.454
