dyeghikoo/design-power-distributor/measures/20.csv.xlsx

# Version 1.00
#
freq[Hz] db:Trc4_S21 ang:Trc4_S21
1.450000000000000E+009 -4.692673638413972E+000 8.620298810538574E+001
1.466000000000000E+009 -4.749633818258189E+000 8.664030968328369E+001
1.482000000000000E+009 -4.210266974857828E+000 8.471874560244345E+001
1.498000000000000E+009 -3.974210039271102E+000 7.598752593737149E+001
1.514000000000000E+009 -4.431634988103581E+000 7.090765048276278E+001
1.530000000000000E+009 -4.841441314763279E+000 6.848158324998440E+001
1.546000000000000E+009 -4.704082595998317E+000 6.906471378240545E+001
1.562000000000000E+009 -4.412895304428388E+000 6.482911643802419E+001
1.578000000000000E+009 -4.230046233331883E+000 5.937135286347918E+001
1.594000000000000E+009 -4.858604270412851E+000 5.480396833191986E+001
1.610000000000000E+009 -5.111638422229815E+000 5.555052806686588E+001
1.626000000000000E+009 -4.974145070680345E+000 5.511591191534001E+001
1.642000000000000E+009 -4.614843370945599E+000 4.965722749734138E+001
1.658000000000000E+009 -4.859625051260581E+000 4.330825955687941E+001
1.674000000000000E+009 -5.287067332393098E+000 4.050092420592236E+001
1.690000000000000E+009 -5.422933234709364E+000 3.914060459027224E+001
1.706000000000000E+009 -5.127207506441066E+000 3.995165594735065E+001
1.722000000000000E+009 -4.781440398208796E+000 3.390835584713074E+001
1.738000000000000E+009 -4.813061258380066E+000 2.932224840175610E+001
1.754000000000000E+009 -5.394158687718925E+000 2.279245065700649E+001
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
4.602000000000000E+009 -4.065531804369480E+000 -1.699660076779892E+002
4.618000000000000E+009 -4.009552824195597E+000 -1.731956648063677E+002
4.634000000000000E+009 -3.835215033342802E+000 -1.758936203421740E+002
4.650000000000000E+009 -3.766891585706719E+000 1.779593178541331E+002
