dyeghikoo/design-power-distributor/measures/00.csv

# Version 1.00
#
freq[Hz] db:Trc4_S11 ang:Trc4_S11
1.450000000000000E+009 -1.977096797749128E+001 6.734008725824339E+001
1.466000000000000E+009 -1.857480335986839E+001 6.220026017585431E+001
1.482000000000000E+009 -1.957861914884594E+001 4.511017295557758E+001
1.498000000000000E+009 -1.847549142511126E+001 4.504377235812130E+001
1.514000000000000E+009 -1.990893839745456E+001 4.175051998221049E+001
1.530000000000000E+009 -1.815516570083251E+001 3.490461149342786E+001
1.546000000000000E+009 -1.801386379986060E+001 3.561915373343945E+001
1.562000000000000E+009 -1.809094666926894E+001 2.715518664446928E+001
1.578000000000000E+009 -1.747933455690977E+001 2.209225328559277E+001
1.594000000000000E+009 -1.783764256412420E+001 1.305591316475183E+001
1.610000000000000E+009 -1.622191577816917E+001 1.058647706363450E+001
1.626000000000000E+009 -1.810992472106879E+001 3.667900605452145E+000
1.642000000000000E+009 -1.809805220248500E+001 -1.831117478791666E+000
1.658000000000000E+009 -1.969552770510455E+001 -3.942464742702049E+000
1.674000000000000E+009 -1.771166413966073E+001 -2.156844691322748E+001
1.690000000000000E+009 -1.701685696735801E+001 -1.935070385291127E+001
1.706000000000000E+009 -1.778158366862169E+001 -1.734367273870309E+001
1.722000000000000E+009 -1.728221527040636E+001 -2.578189738095032E+001
1.738000000000000E+009 -1.701845412581524E+001 -2.917053936373896E+001
1.754000000000000E+009 -1.663051520727250E+001 -3.429153656492032E+001
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
4.602000000000000E+009 -1.185439099297630E+001 -6.268226000970272E+000
4.618000000000000E+009 -1.188845076901591E+001 -1.038018084884526E+001
4.634000000000000E+009 -1.131723421109035E+001 -2.059367077338306E+001
4.650000000000000E+009 -1.098041678903080E+001 -2.297134740265966E+001
