dyeghikoo/design-power-distributor/measures/10.csv

# Version 1.00
#
freq[Hz] db:Trc4_S21 ang:Trc4_S21
1.450000000000000E+009 -7.384756110006112E+000 6.615383099663896E+001
1.466000000000000E+009 -7.439815602508788E+000 6.977745591066592E+001
1.482000000000000E+009 -6.507996653398815E+000 6.764173666329756E+001
1.498000000000000E+009 -6.311521641036170E+000 5.796743318359744E+001
1.514000000000000E+009 -6.997863260617566E+000 5.152556106992520E+001
1.530000000000000E+009 -7.578636277505360E+000 4.963822846576532E+001
1.546000000000000E+009 -7.280221390395712E+000 5.143281873876533E+001
1.562000000000000E+009 -6.807428407330484E+000 4.765081256865472E+001
1.578000000000000E+009 -6.697904037124586E+000 4.079857976238732E+001
1.594000000000000E+009 -7.497542491224439E+000 3.594501638228992E+001
1.610000000000000E+009 -7.820304842727849E+000 3.825903908344059E+001
1.626000000000000E+009 -7.574461295780015E+000 3.927860460517294E+001
1.642000000000000E+009 -7.033733694958362E+000 3.199746574281131E+001
1.658000000000000E+009 -7.388346989212056E+000 2.484789391280461E+001
1.674000000000000E+009 -7.953050091897731E+000 2.099873222878050E+001
1.690000000000000E+009 -8.268657927012917E+000 2.247419348619867E+001
1.706000000000000E+009 -7.773759552912019E+000 2.319986466559681E+001
1.722000000000000E+009 -7.201998308283752E+000 1.832222702013760E+001
1.738000000000000E+009 -7.329697569394098E+000 1.015713443357796E+001
1.754000000000000E+009 -8.125112659052260E+000 4.934823575729930E+000
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
4.602000000000000E+009 -6.455142392897821E+000 1.591120981134703E+002
4.618000000000000E+009 -5.882890483782131E+000 1.599245088984947E+002
4.634000000000000E+009 -4.841473590505983E+000 1.562115515915276E+002
4.650000000000000E+009 -4.383069473997696E+000 1.442835240949652E+002
