dyeghikoo/design-power-distributor/measures/30.csv

# Version 1.00
#
freq[Hz] db:Trc4_S21 ang:Trc4_S21
1.450000000000000E+009 -7.659998942619527E+000 7.957534628037091E+001
1.466000000000000E+009 -7.852945942153424E+000 8.269854861375191E+001
1.482000000000000E+009 -7.037390654819682E+000 8.375589055833571E+001
1.498000000000000E+009 -6.643034519356575E+000 7.555216790797294E+001
1.514000000000000E+009 -7.206704893477965E+000 6.720096785865684E+001
1.530000000000000E+009 -7.732000782070498E+000 6.750886451267118E+001
1.546000000000000E+009 -7.670582228291857E+000 6.755689286011712E+001
1.562000000000000E+009 -7.138880550472182E+000 6.506768653567700E+001
1.578000000000000E+009 -6.837265827069158E+000 6.091535394152199E+001
1.594000000000000E+009 -7.610852667040519E+000 5.184434214537321E+001
1.610000000000000E+009 -8.073889959868536E+000 5.598256435607613E+001
1.626000000000000E+009 -7.883041895050392E+000 5.511804503416109E+001
1.642000000000000E+009 -7.291120612777911E+000 5.108605401088779E+001
1.658000000000000E+009 -7.416826430190626E+000 4.256849975969078E+001
1.674000000000000E+009 -7.888587949665926E+000 3.862988203686676E+001
1.690000000000000E+009 -8.310249976094035E+000 3.920745445666579E+001
1.706000000000000E+009 -8.054466908984820E+000 4.029905215721023E+001
1.722000000000000E+009 -7.407004421539152E+000 3.551517195767134E+001
1.738000000000000E+009 -7.311460349052451E+000 2.861118575691221E+001
1.754000000000000E+009 -7.878953691855524E+000 2.257043934567183E+001
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
4.602000000000000E+009 -5.713776674372604E+000 -1.476470029750009E+002
4.618000000000000E+009 -5.855072268095908E+000 -1.542363700211866E+002
4.634000000000000E+009 -5.889429902775843E+000 -1.574247387987670E+002
4.650000000000000E+009 -5.797180323949442E+000 -1.593225444802469E+002
