dyeghikoo/design-power-distributor/measures/00.PNG

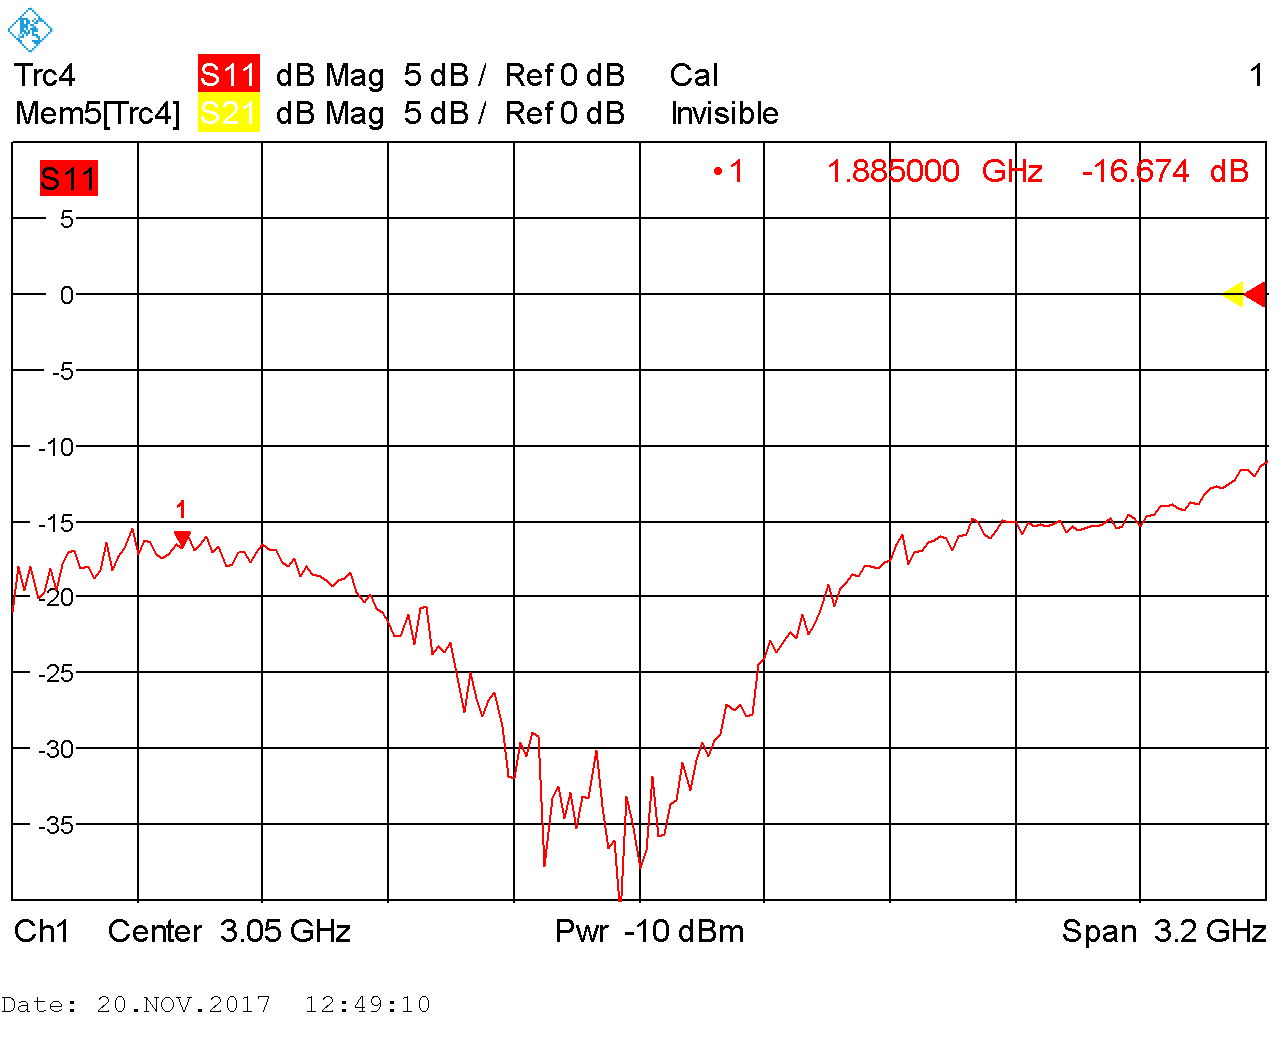
measures/00.PNG
