dyeghikoo/design-power-distributor/measures/12A.PNG

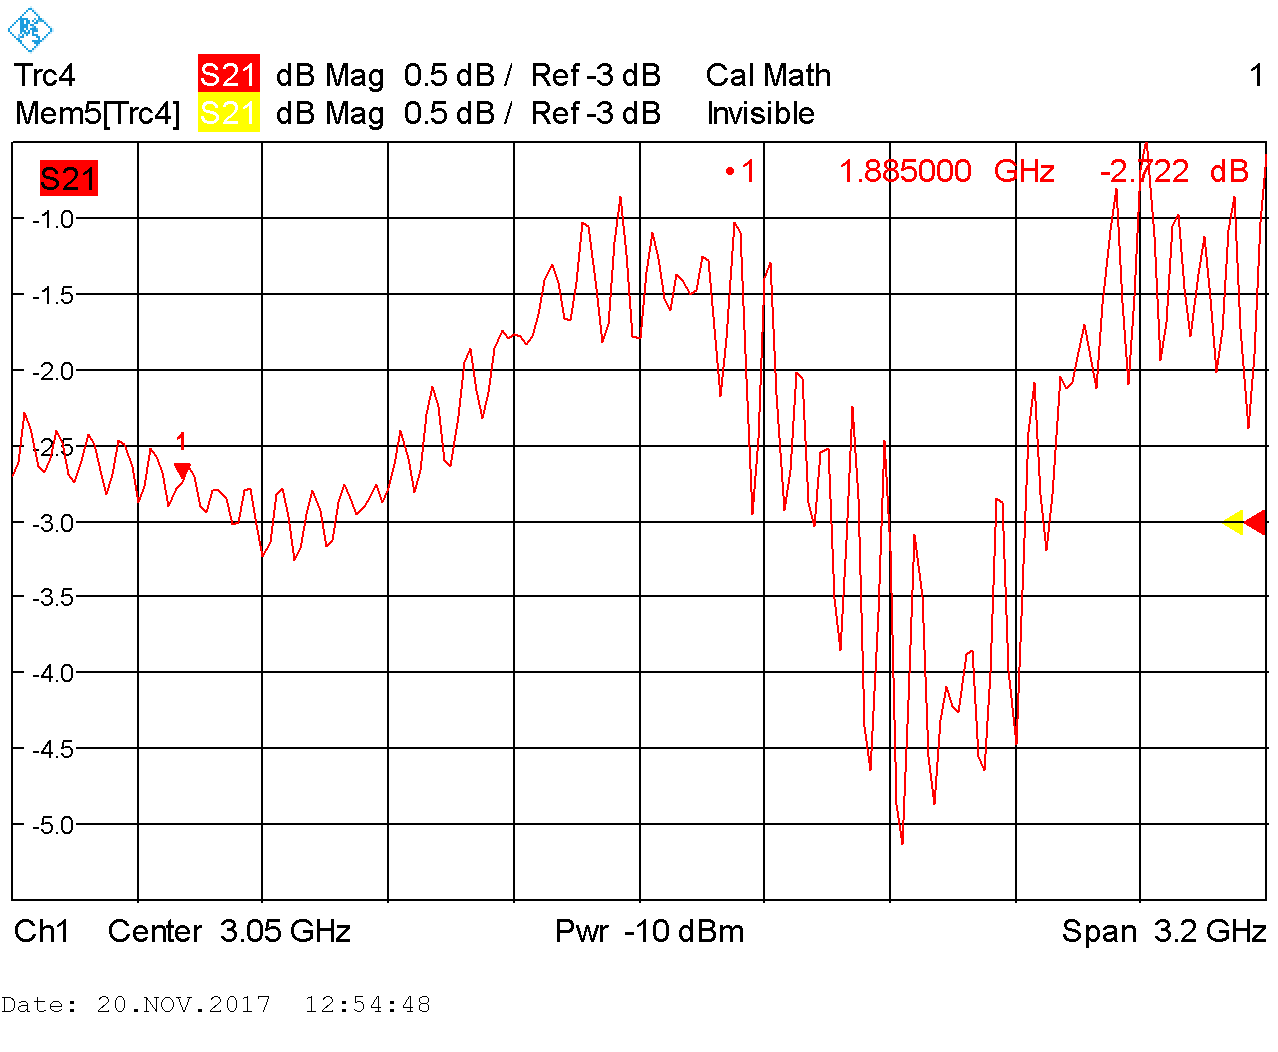
measures/12A.PNG
