dyeghikoo/design-power-distributor/measures/12F.PNG

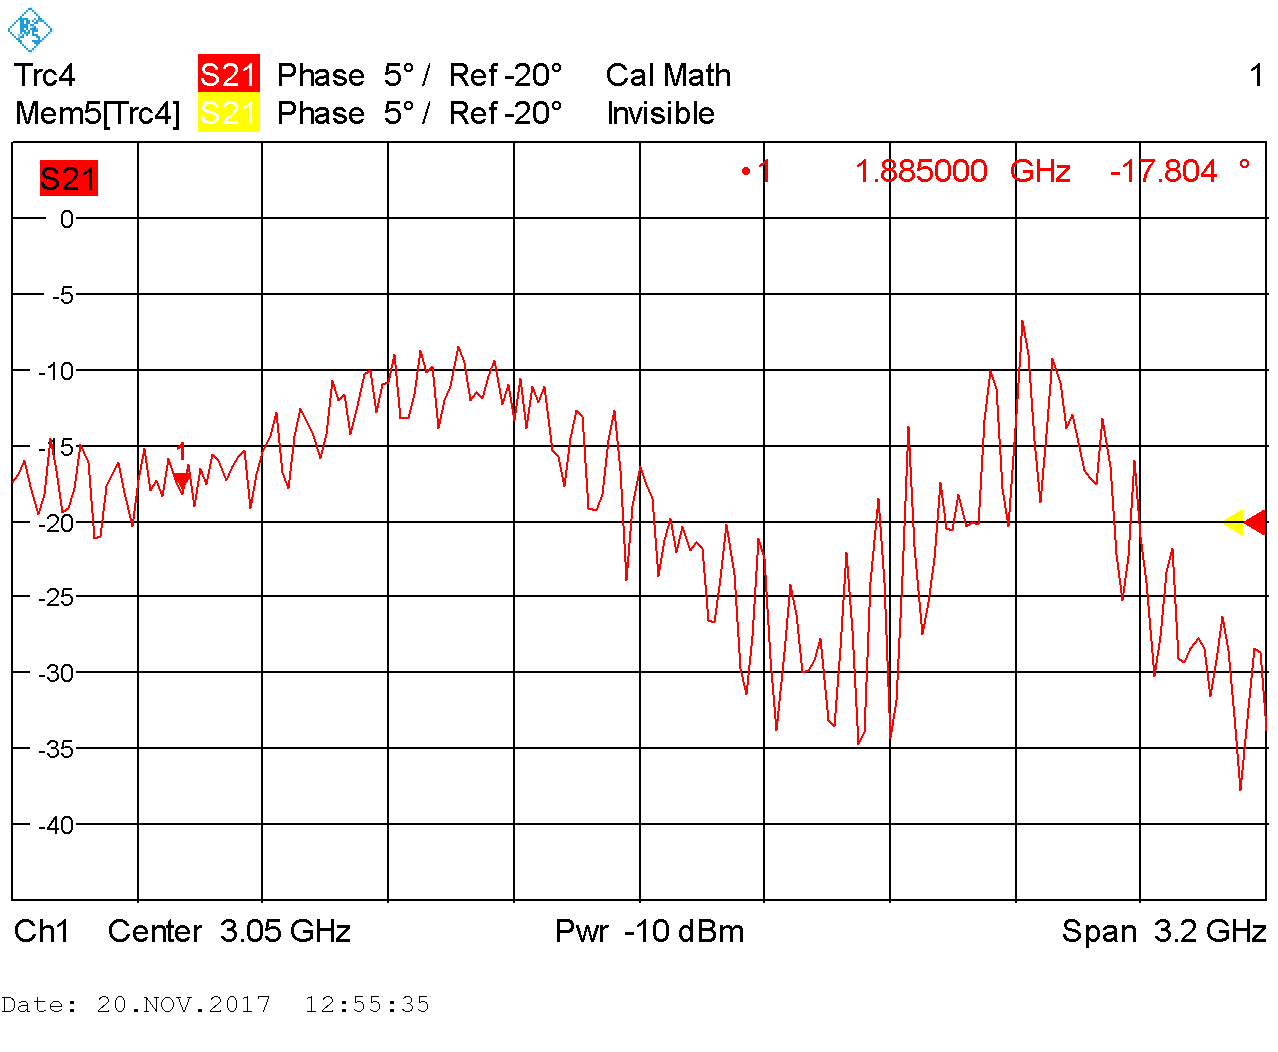
measures/12F.PNG
