dyeghikoo/design-power-distributor/measures/32A.PNG

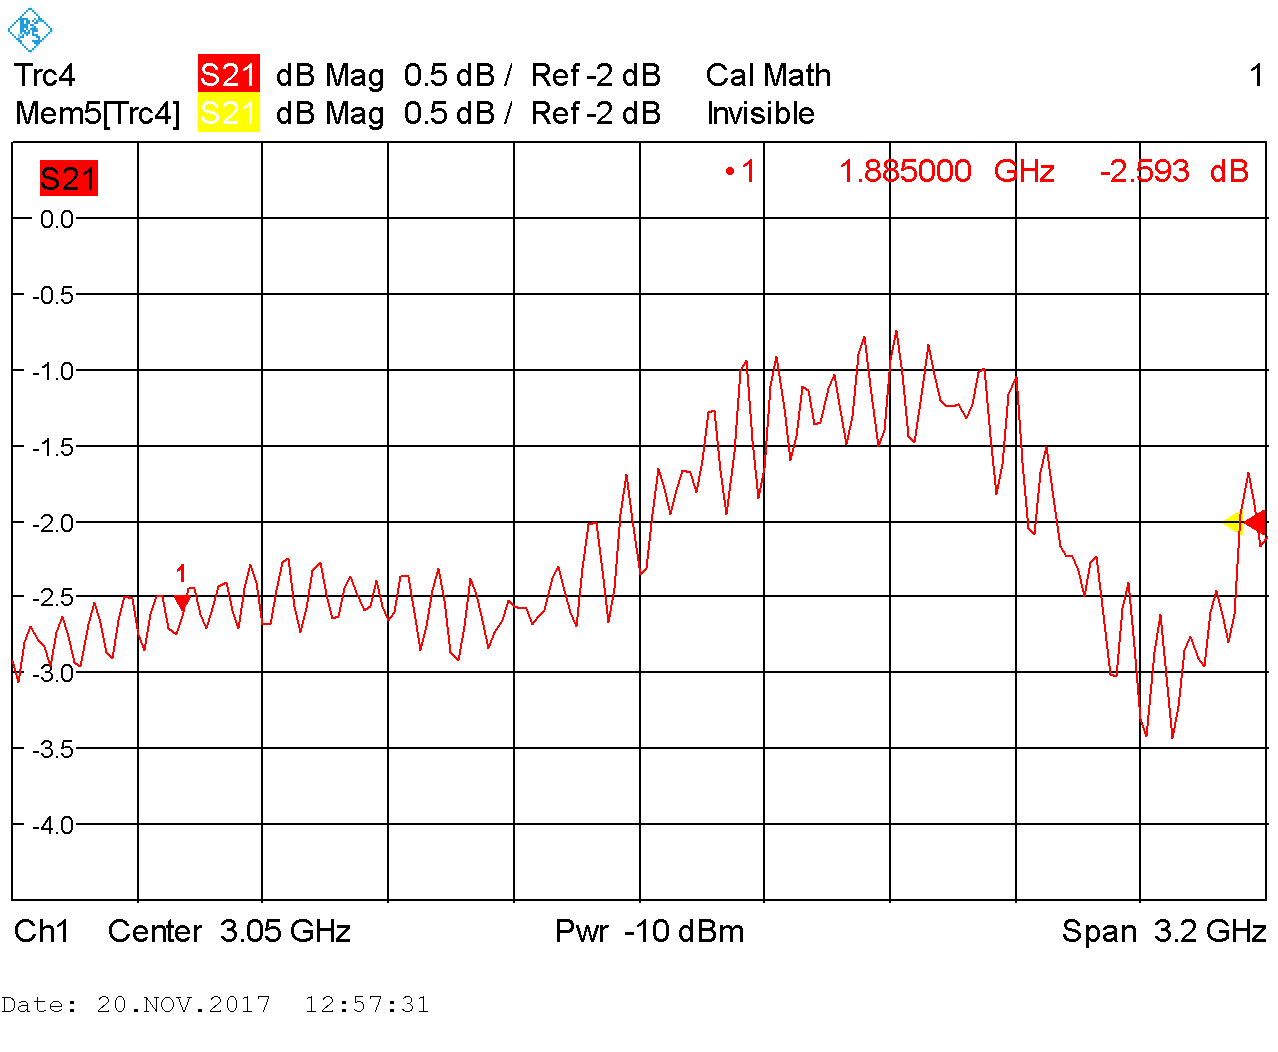
measures/32A.PNG
