dyeghikoo/design-power-distributor/measures/32F.PNG

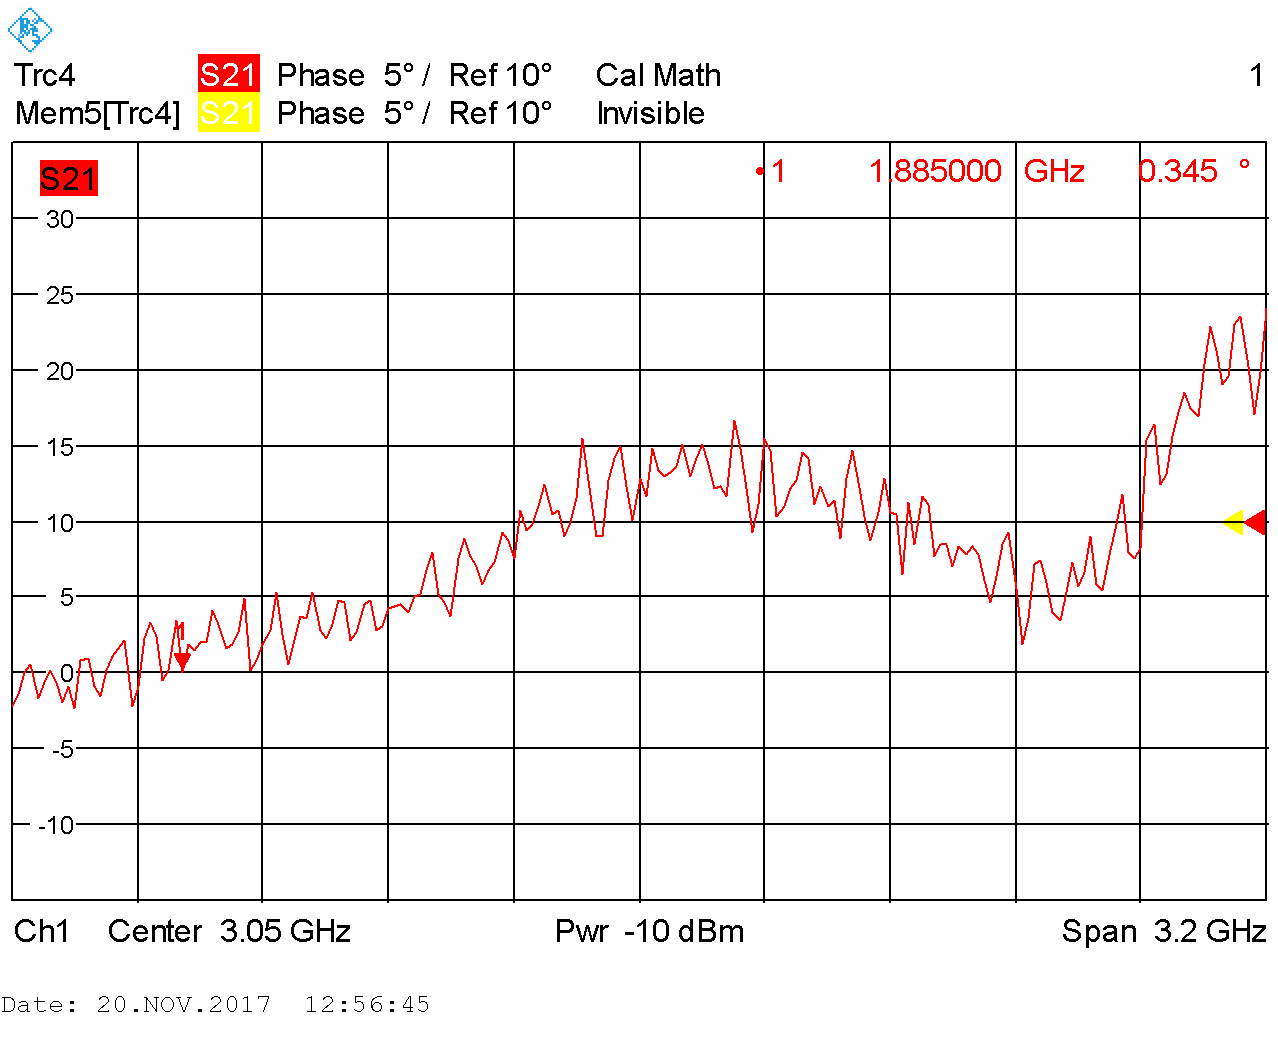
measures/32F.PNG
