dyeghikoo/design-power-distributor/measures/42A.PNG

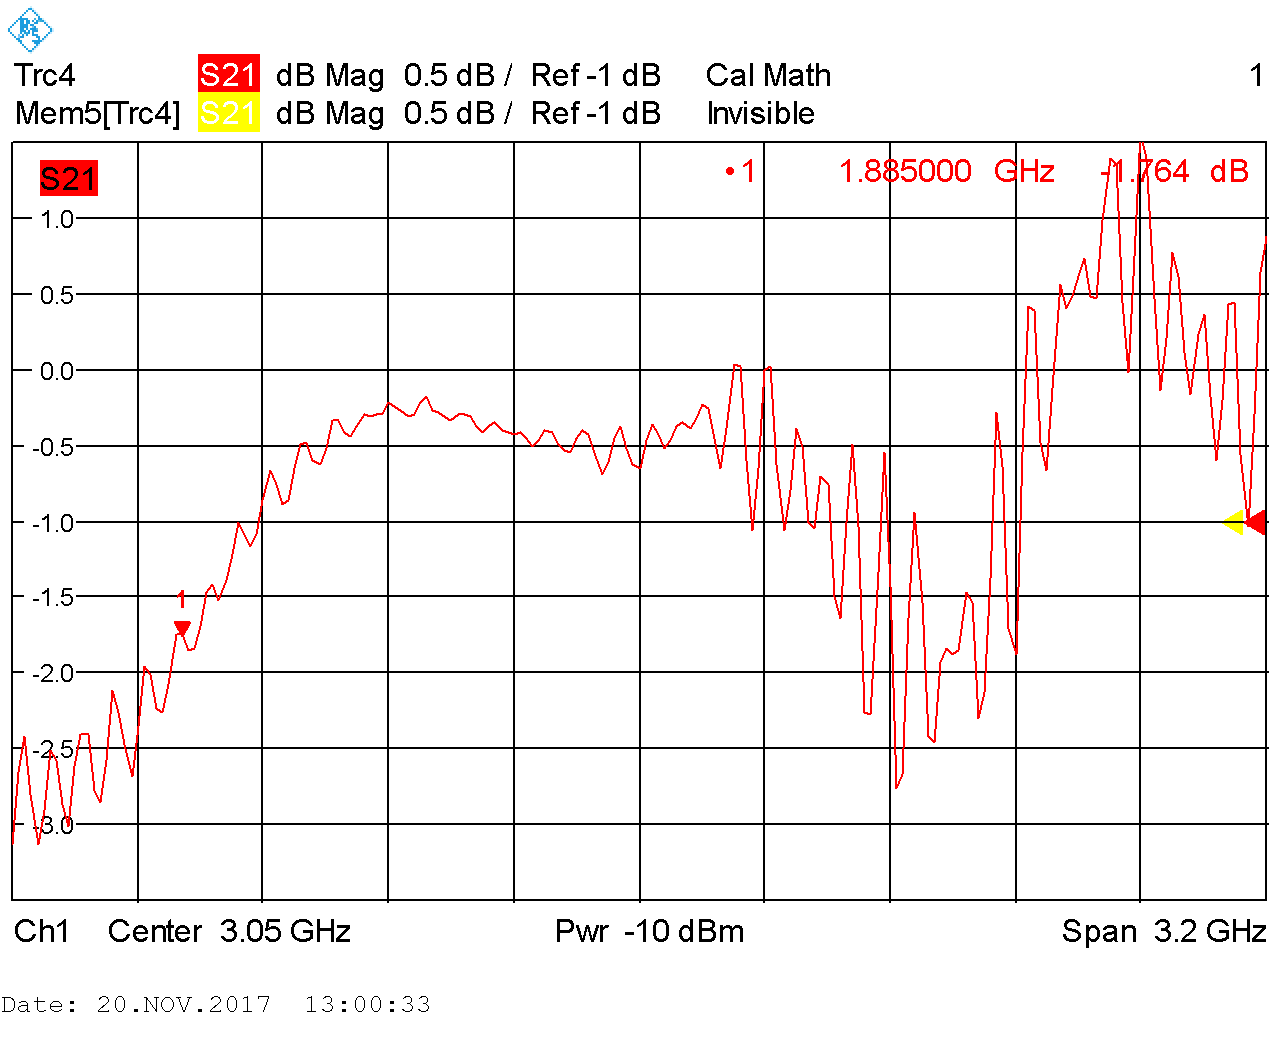
measures/42A.PNG
