dyeghikoo/design-power-distributor/measures/42F.PNG

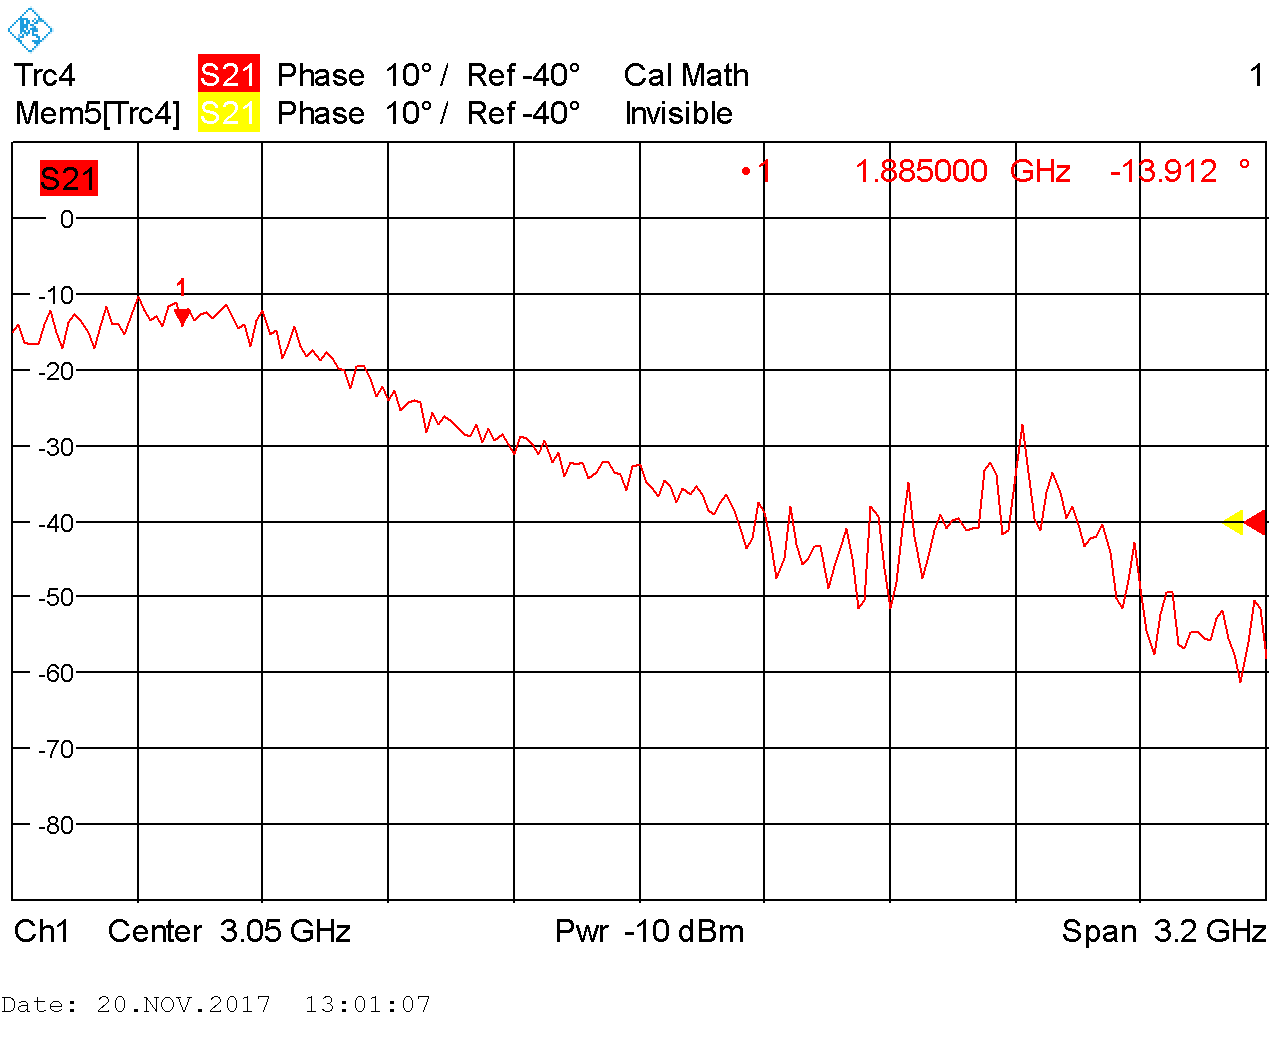
measures/42F.PNG
