dyeghikoo/design-power-distributor/MEMORIA STEP2.pdf

## Daniel Sanz Muñoz Juan Diego Sierra Fernández

# PRÁCTICAS MEDIOS DE TRANSMISIÓN

## PRACTICA 2

# Punto 1

# Rama 1

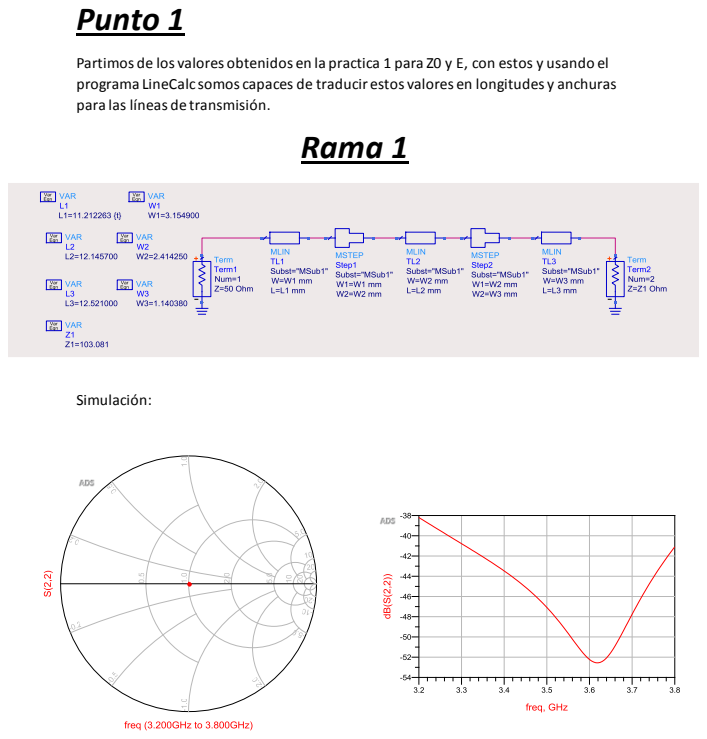
[picture p54: page 2]
Simulación:

Partimos de los valores obtenidos en la practica 1 para Z0 y E, con estos y usando el
programa LineCalc somos capaces de traducir estos valores en longitudes y anchuras
para las líneas de transmisión.

# Rama 2

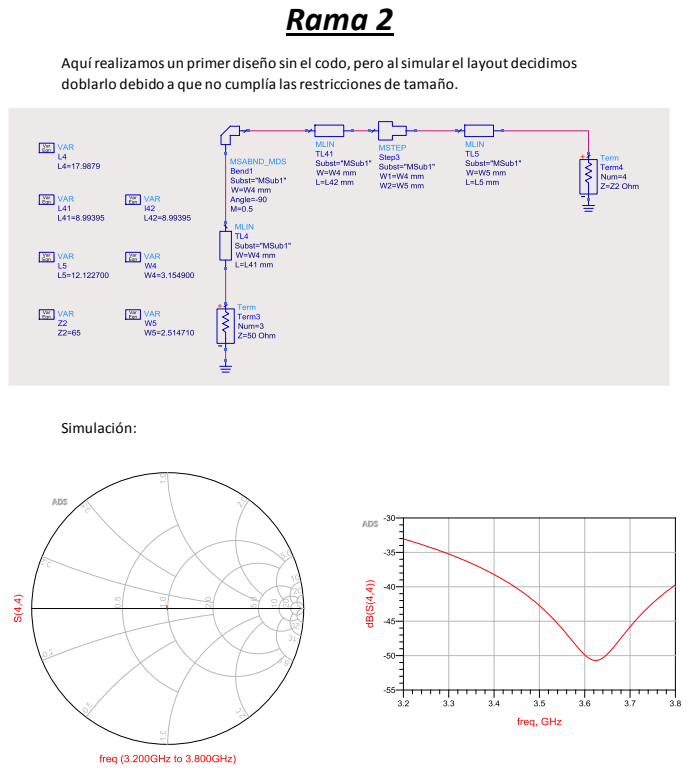
[picture p55: page 3]
Simulación:

Aquí realizamos un primer diseño sin el codo, pero al simular el layout decidimos
doblarlo debido a que no cumplía las restricciones de tamaño.

# Rama 3

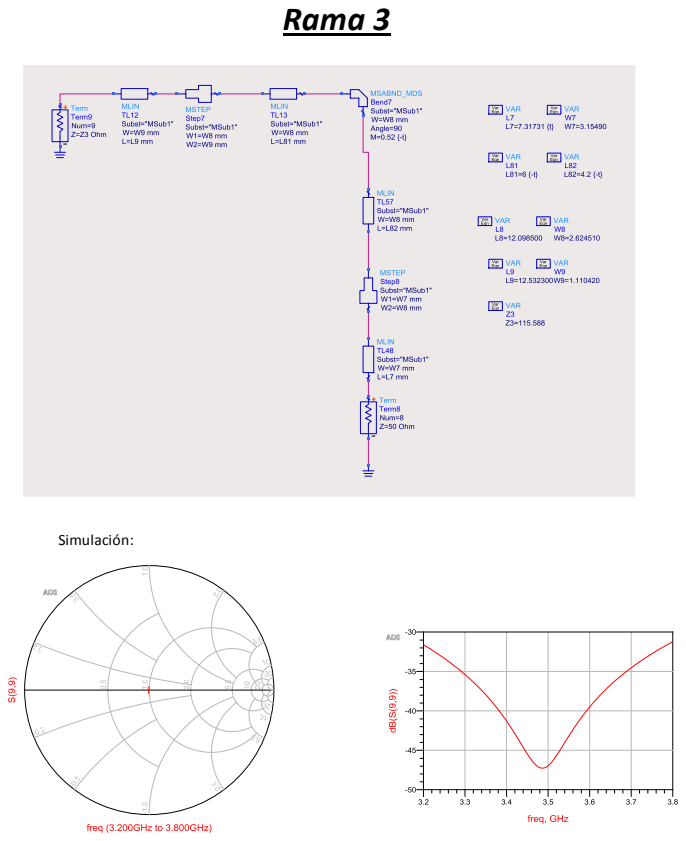
[picture p56: page 4]
Simulación:

# Rama 4

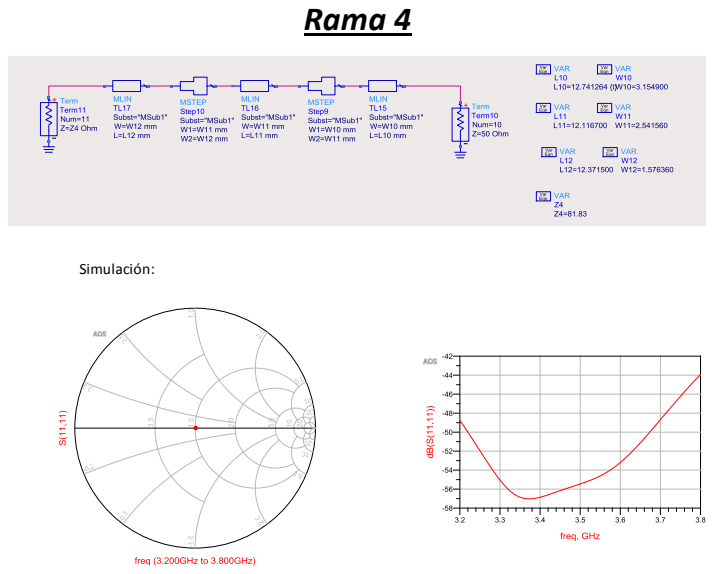
[picture p57: page 5]
Simulación:

# Rama 1,2

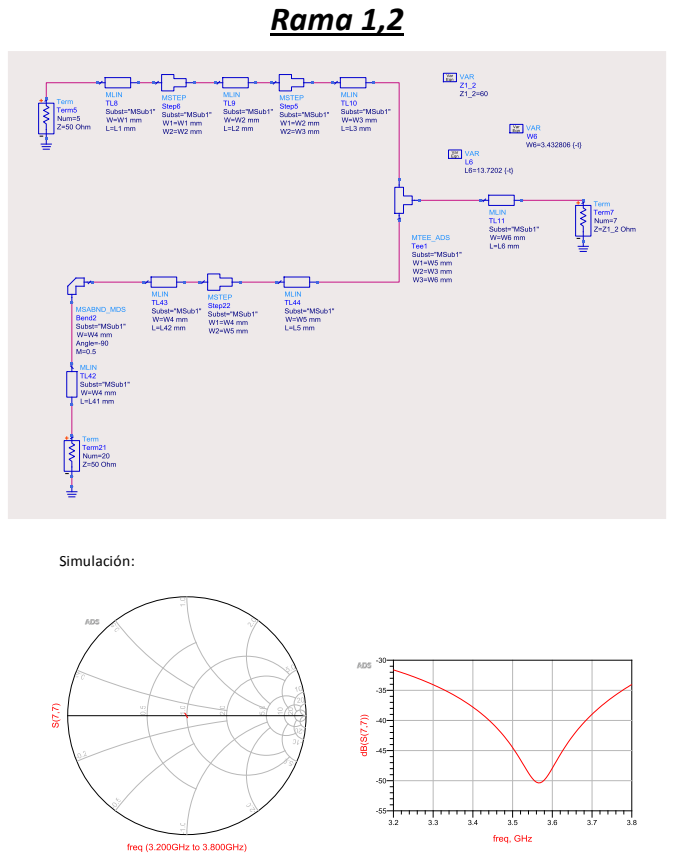
[picture p58: page 6]
Simulación:

# Rama 3,4

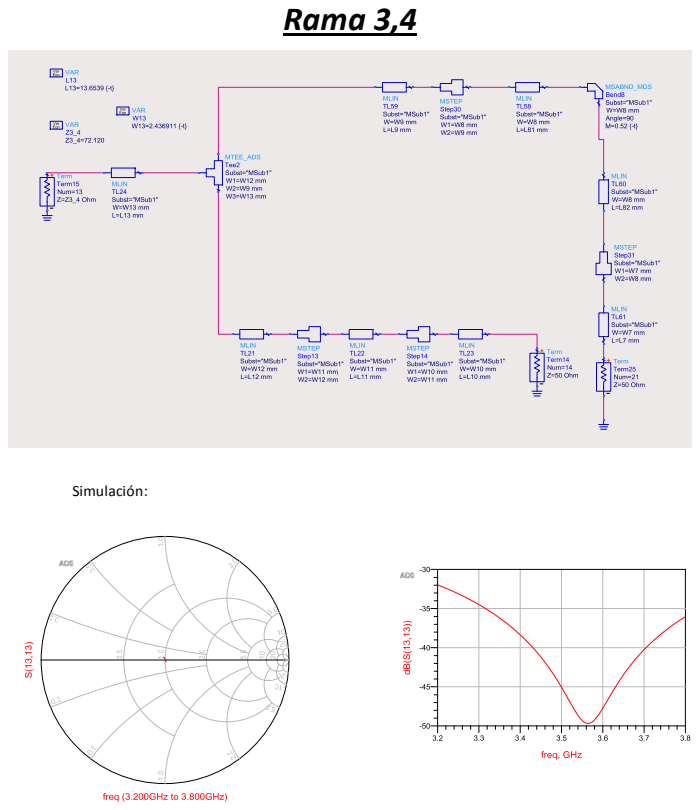
[picture p59: page 7]
Simulación:

# Circuito al completo

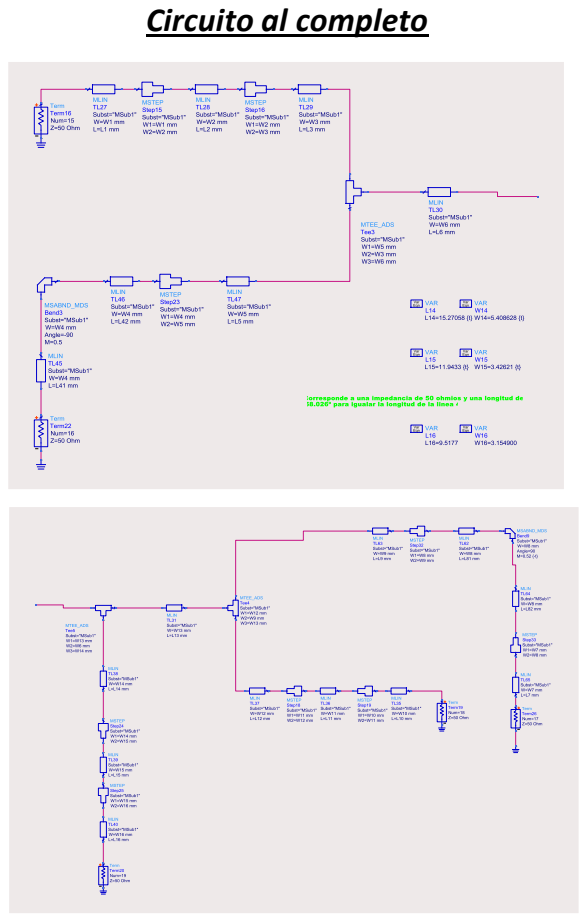
[picture p60: page 8]

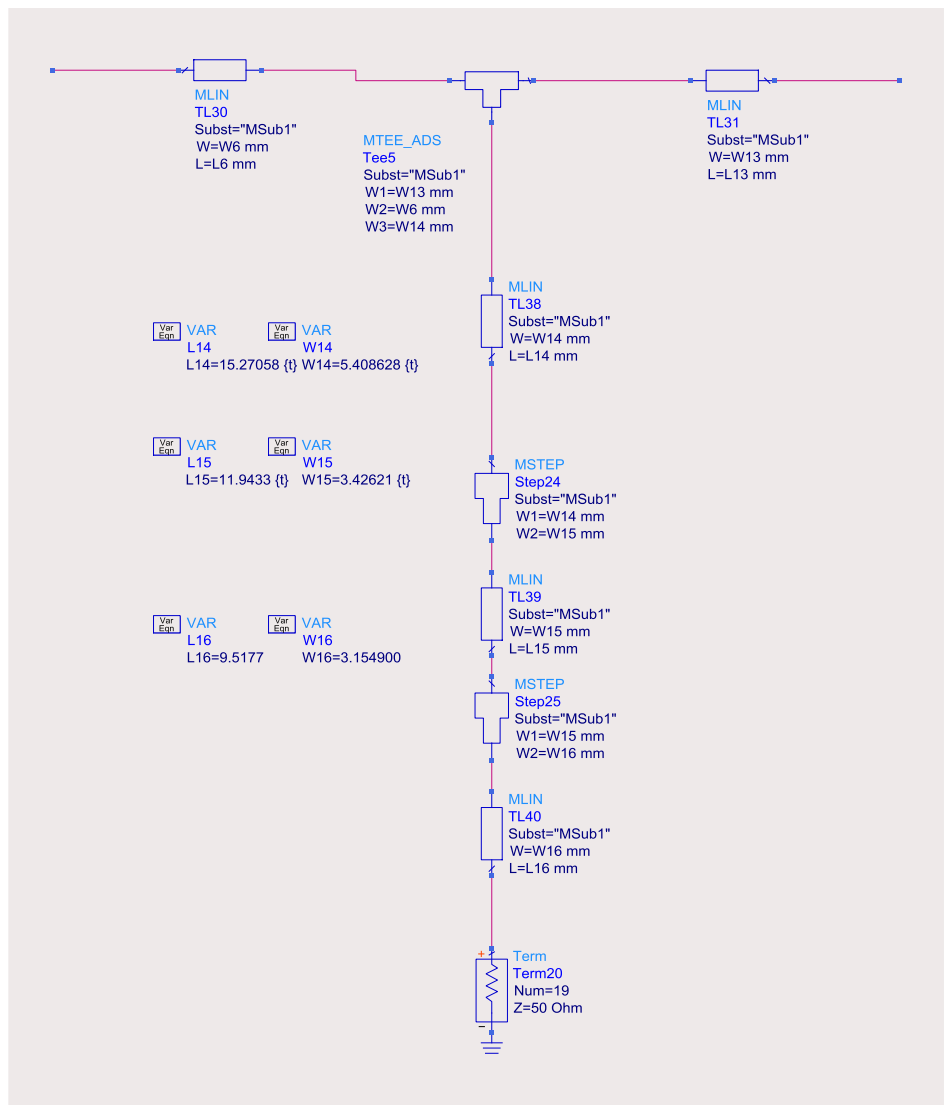
[picture p61: page 9]

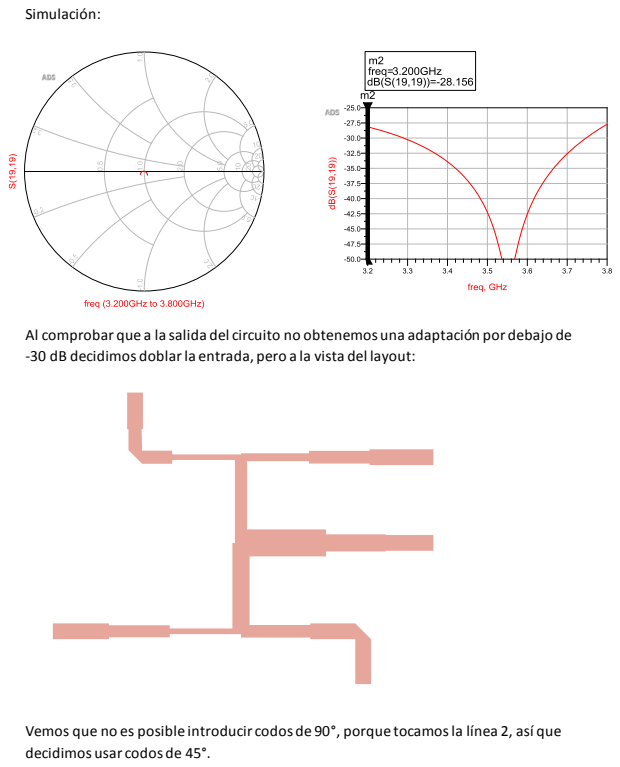
[picture p62: page 10]
Simulación:

Al comprobar que a la salida del circuito no obtenemos una adaptación por debajo de
-30 dB decidimos doblar la entrada, pero a la vista del layout:

Vemos que no es posible introducir codos de 90°, porque tocamos la línea 2, así que
decidimos usar codos de 45°.

# Entrada con codos de 45°

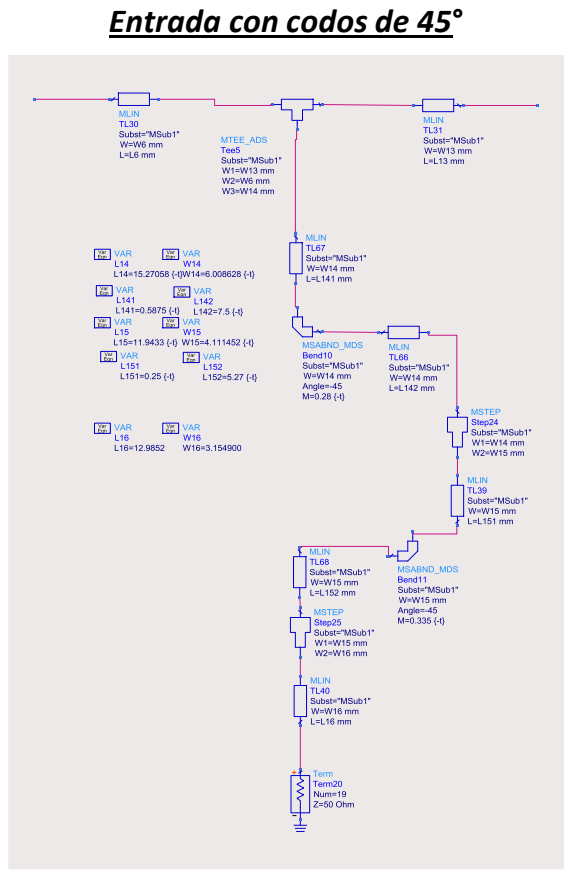
[picture p63: page 11]

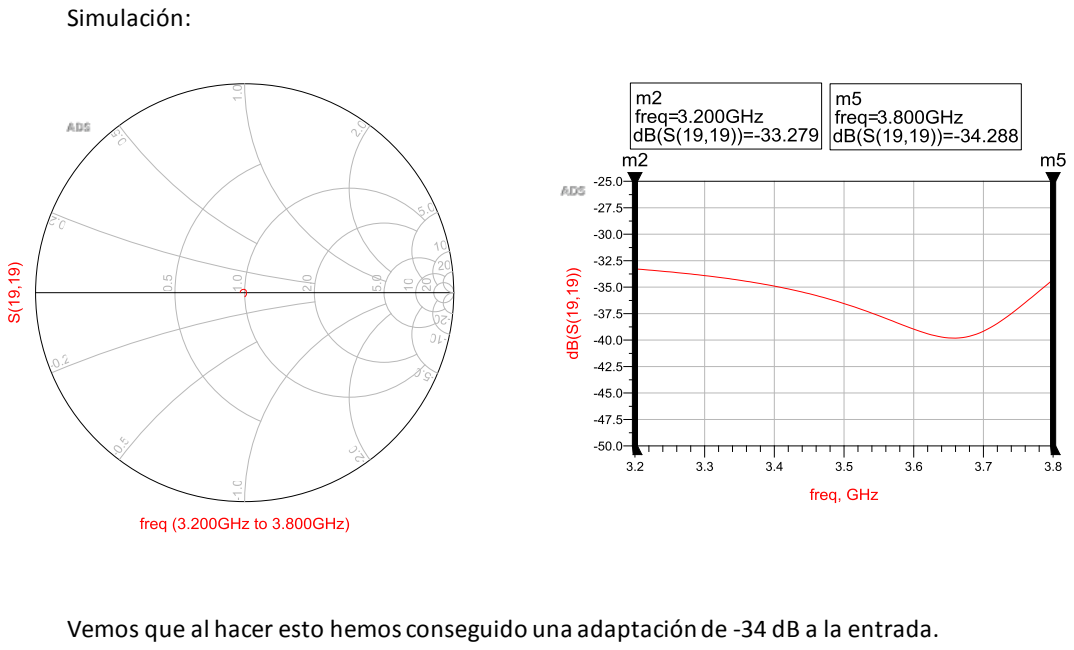
[picture p64: page 12]
Simulación:

Vemos que al hacer esto hemos conseguido una adaptación de -34 dB a la entrada.

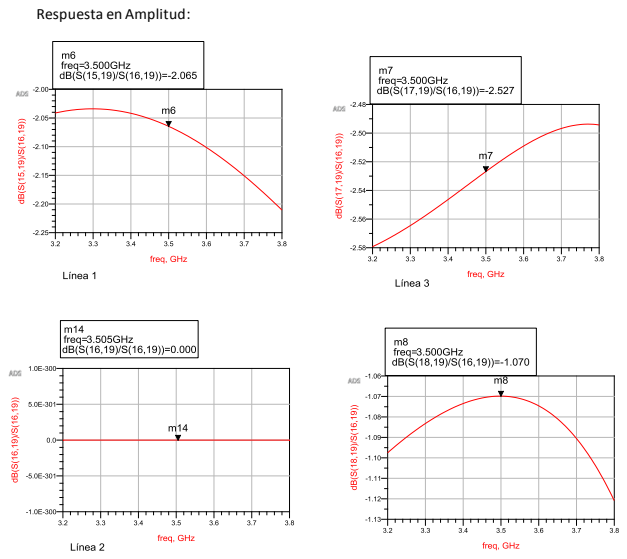
[picture p65: page 13]

Respuesta en Amplitud:

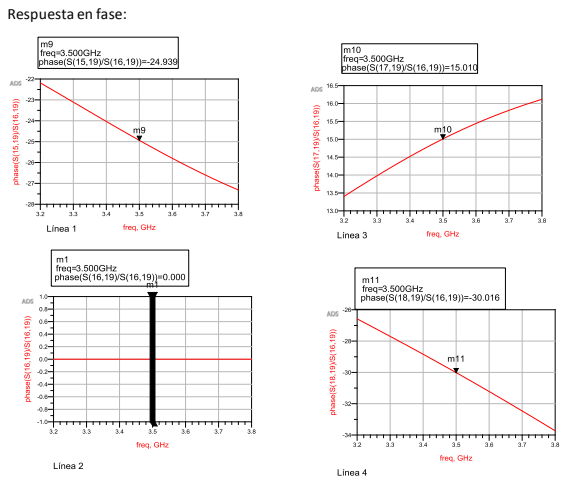
[picture p66: page 14]

Respuesta en fase:

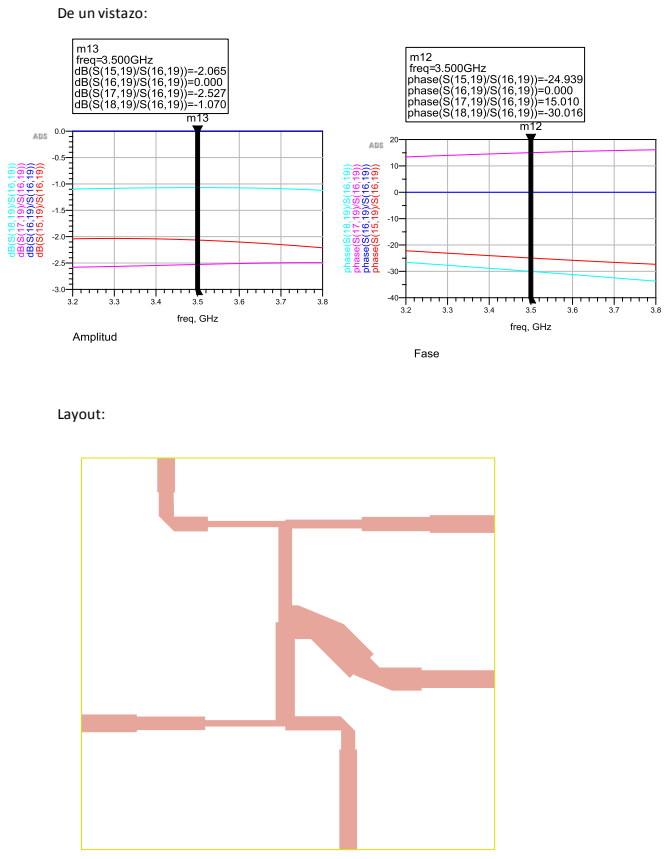
[picture p67: page 15]
Layout:

De un vistazo:

# Punto 2

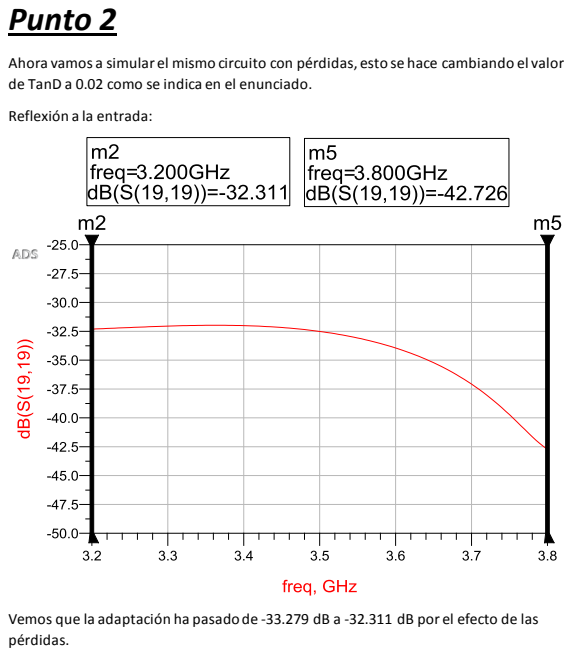
[picture p68: page 16]

Ahora vamos a simular el mismo circuito con pérdidas, esto se hace cambiando el valor
de TanD a 0.02 como se indica en el enunciado.

Reflexión a la entrada:

Vemos que la adaptación ha pasado de -33.279 dB a -32.311 dB por el efecto de las
pérdidas.

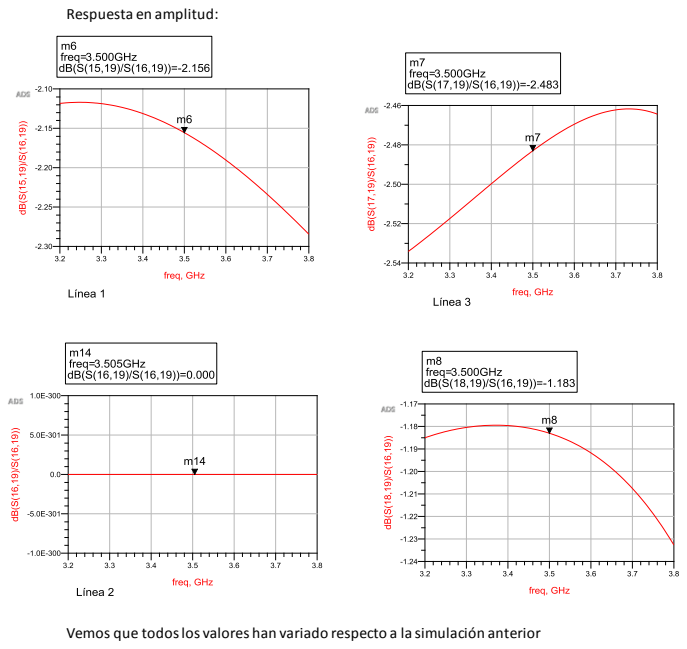
[picture p69: page 17]

Respuesta en amplitud:

Vemos que todos los valores han variado respecto a la simulación anterior

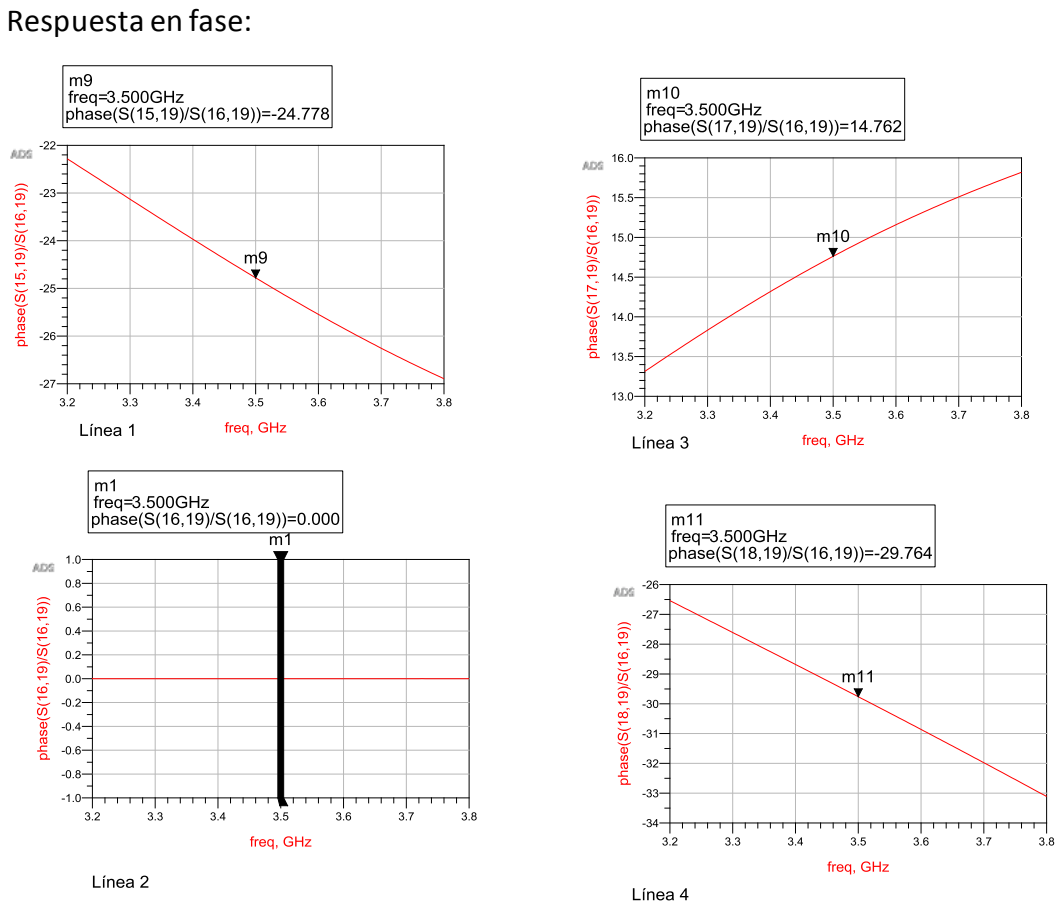
[picture p70: page 18]

Respuesta en fase:

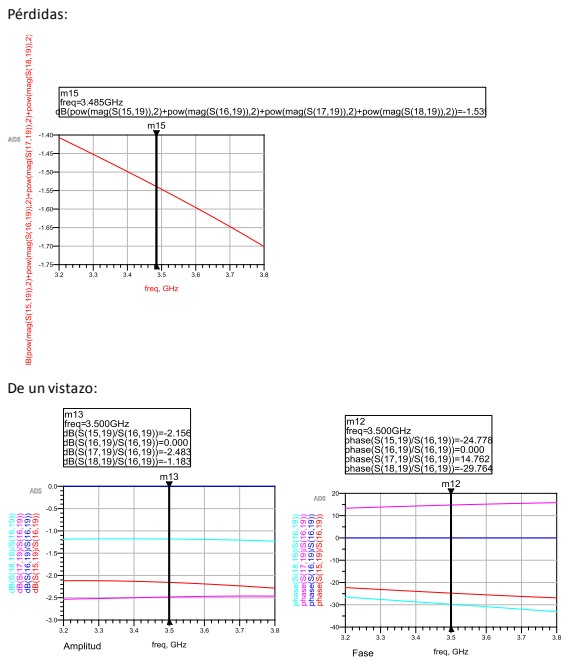
[picture p71: page 19]
Pérdidas:

De un vistazo:

# Punto 3

Reflexión a la entrada del circuito:

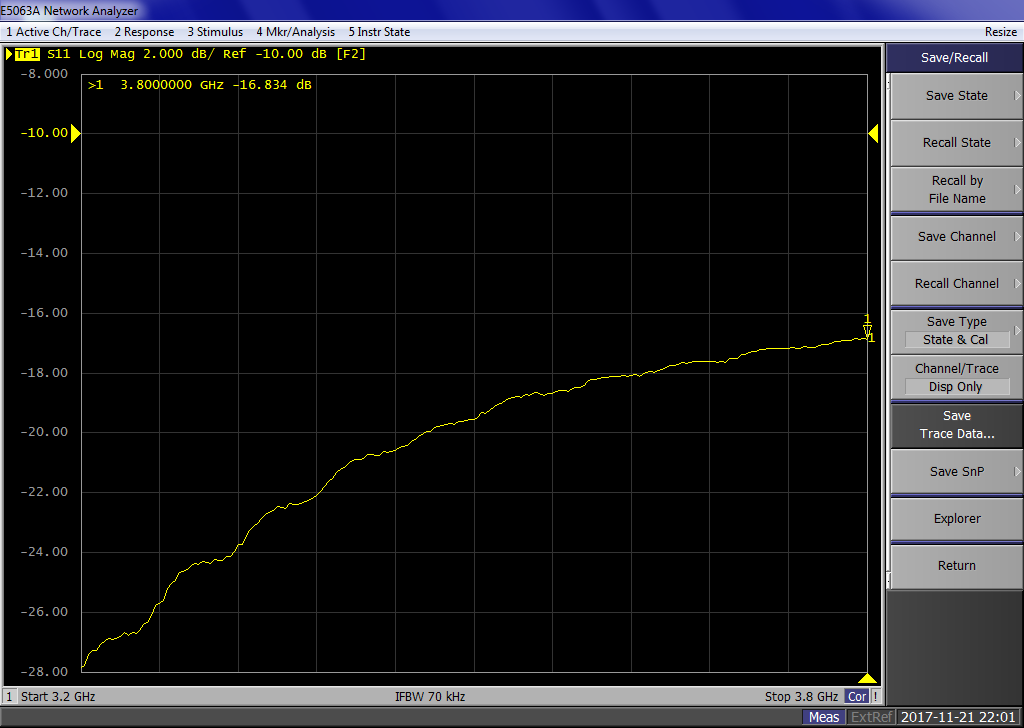
[picture p72: figure]

Transmisión en amplitud y fase a la línea 1:

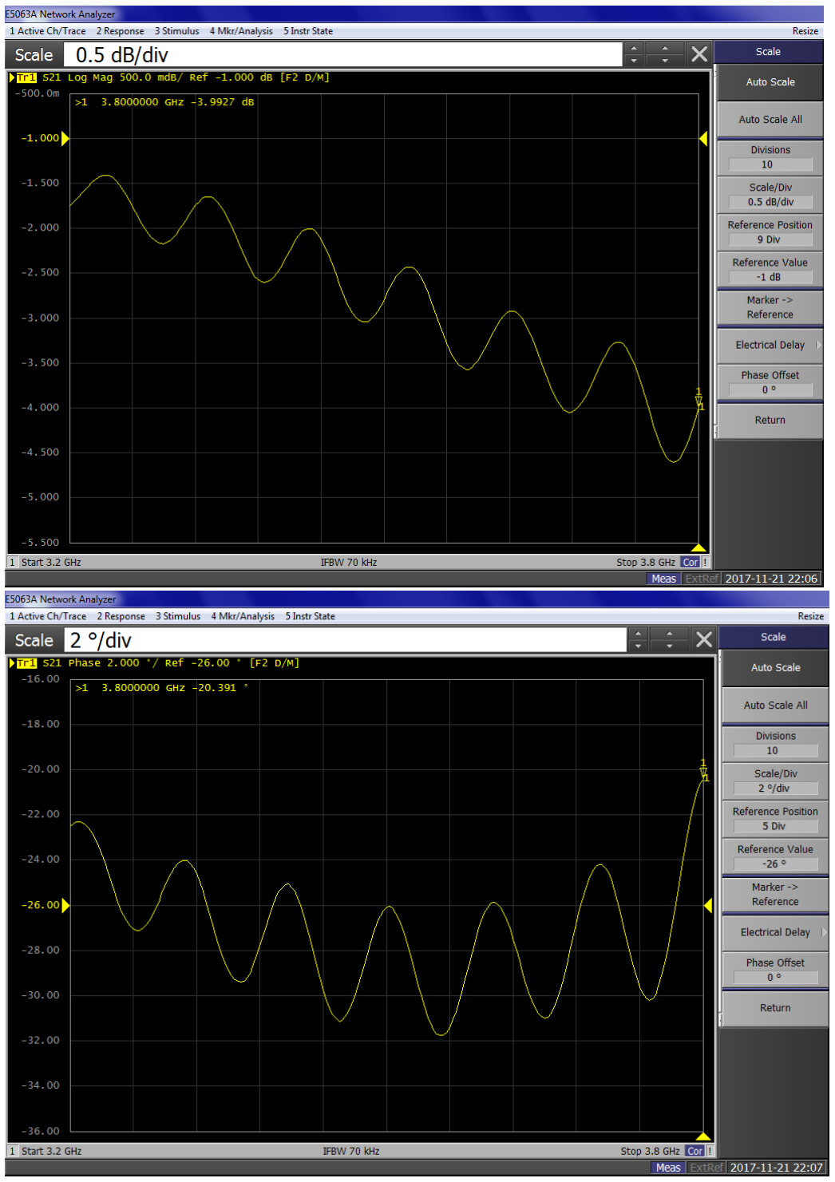
[picture p73: figure]

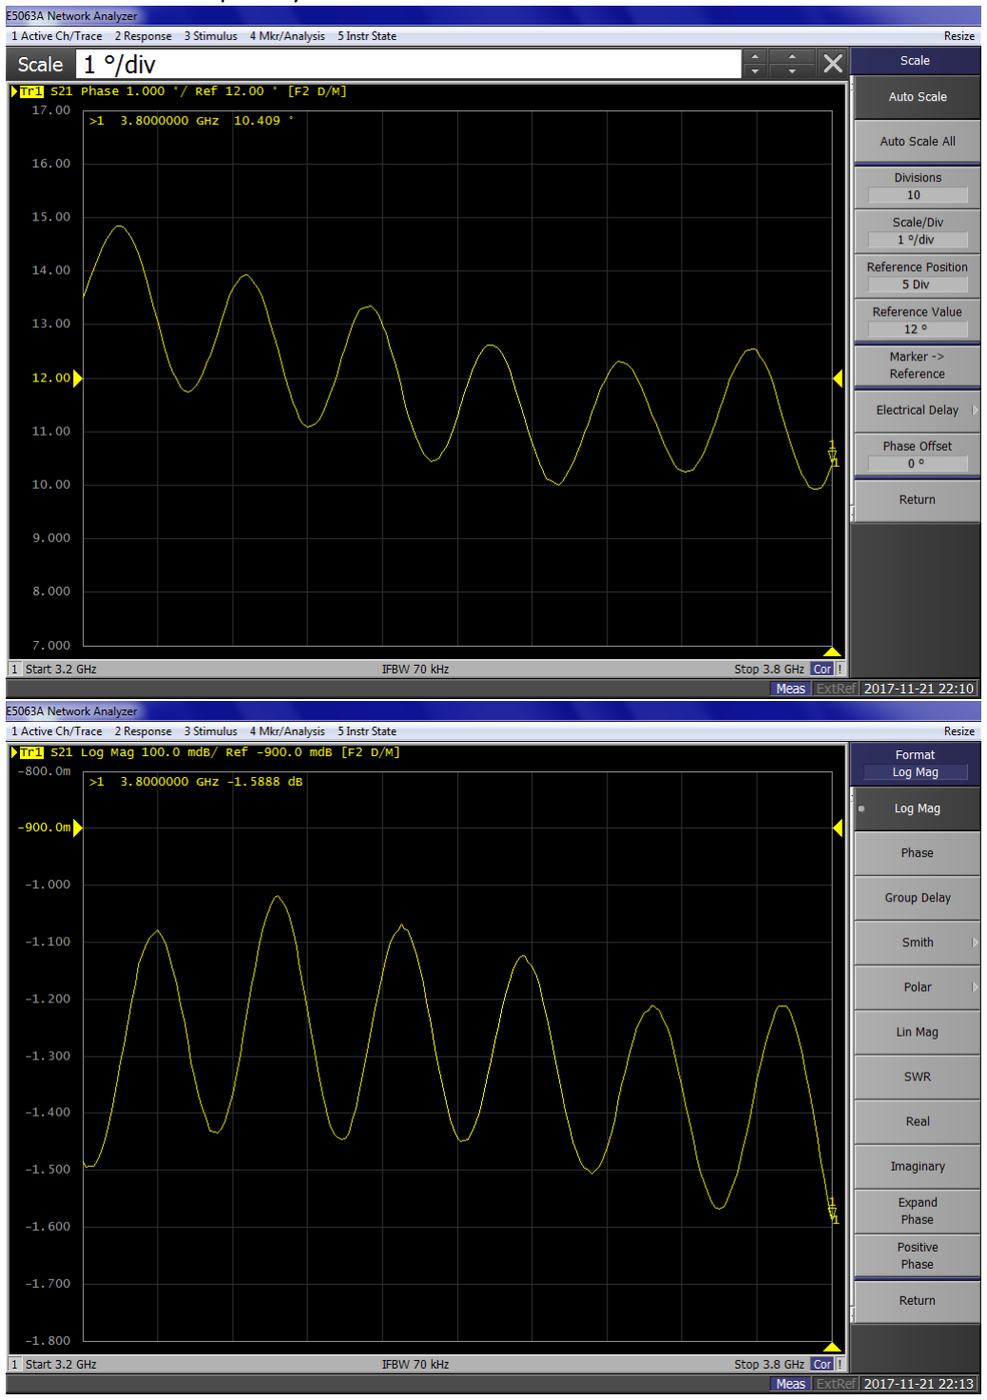
[picture p74: figure]

Transmisión en amplitud y fase a la línea 3:

Transmisión en amplitud y fase a la línea 4:

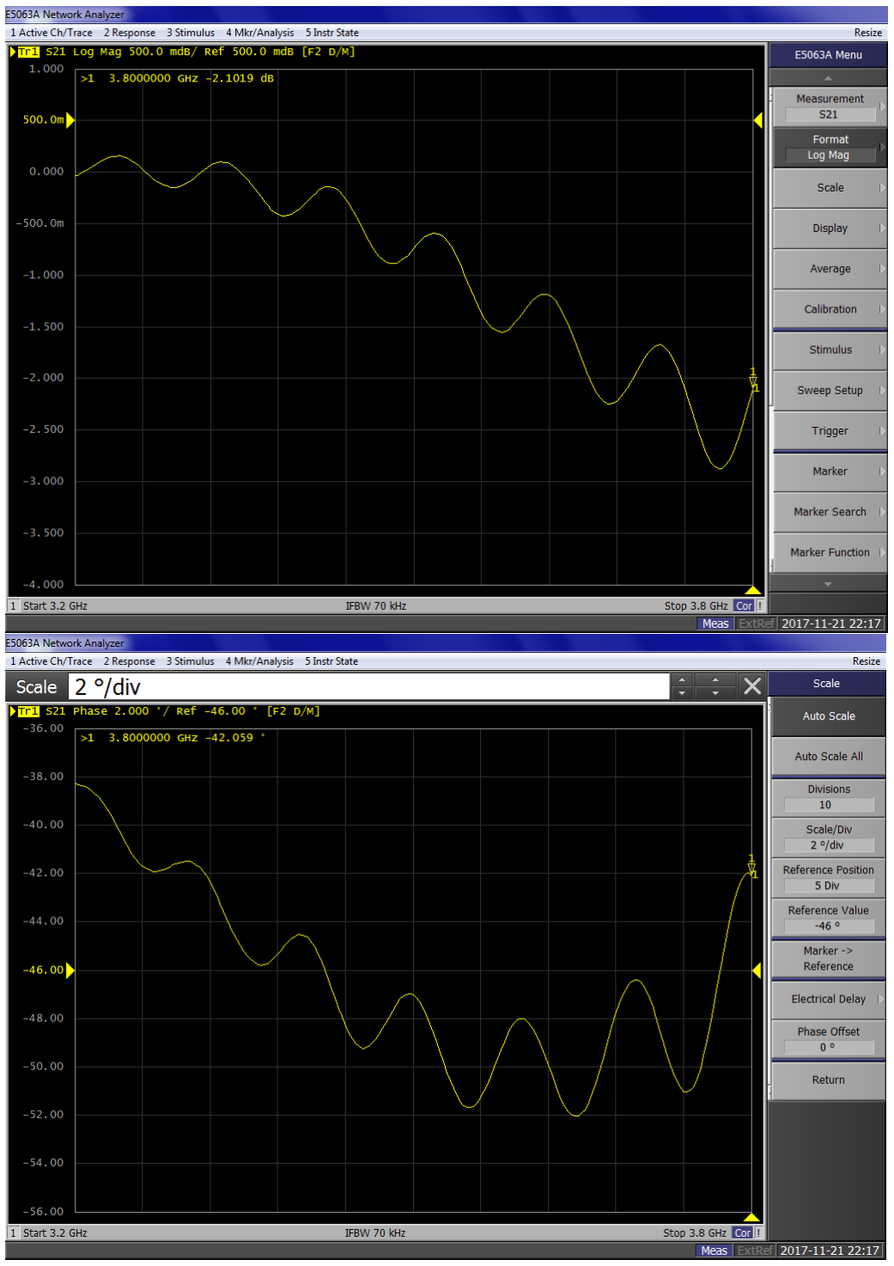
[picture p75: figure]
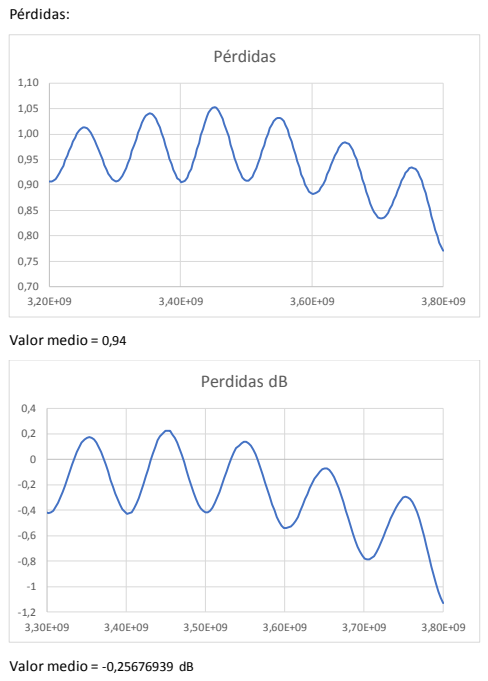
[picture p76: page 24]
Pérdidas:; Valor medio = 0,94; Pérdidas; Perdidas dB

Valor medio = -0,25676939 dB
